wiznetmaker-contest/W5300-Camera-ToF-3D/docs/with-transformer.jpg

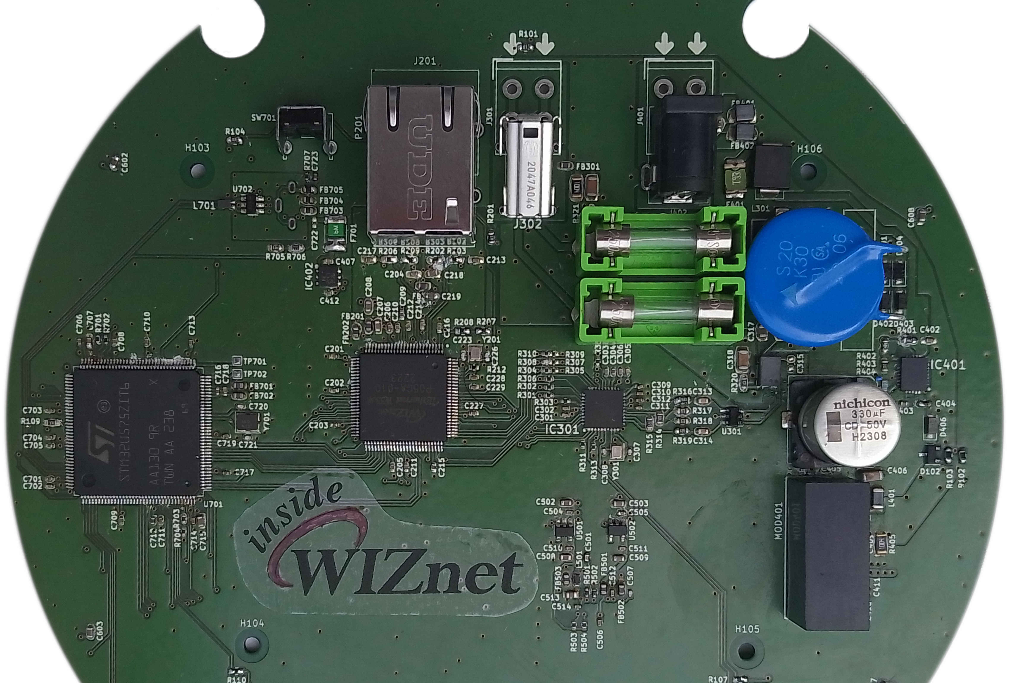
docs/with-transformer.jpg
