wiznetmaker-contest/W5300-Camera-ToF-3D/docs/PCB-Top.jpg

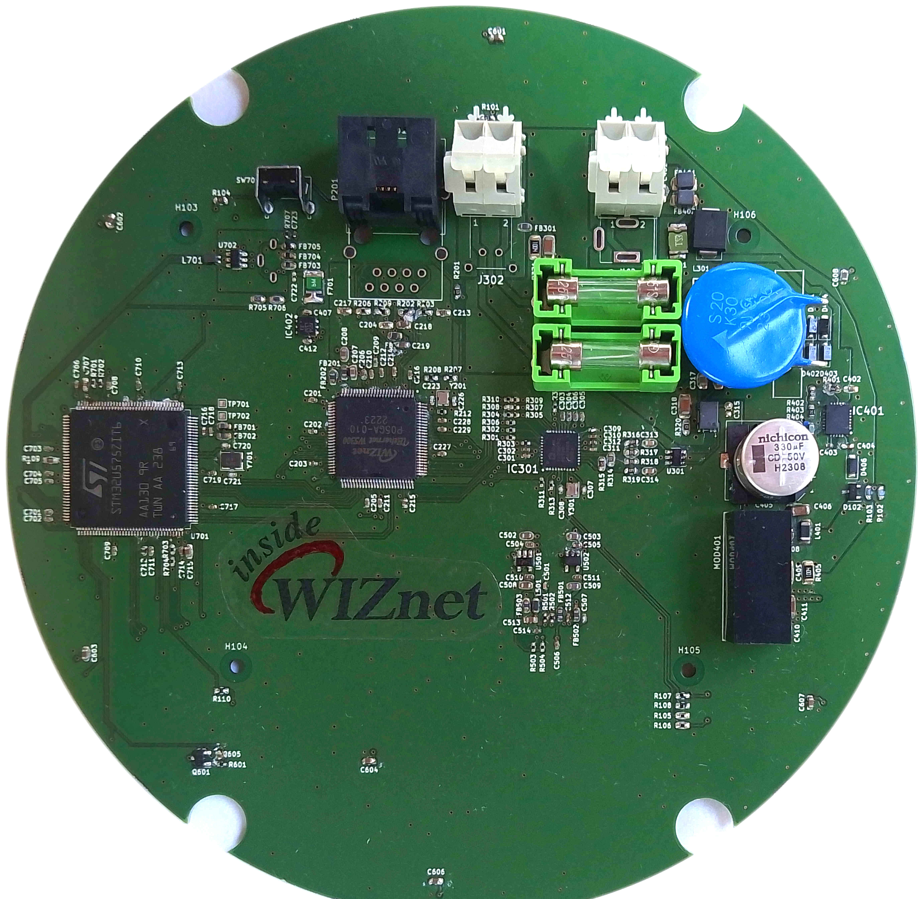
docs/PCB-Top.jpg
