wiznetmaker-contest/W5300-Camera-ToF-3D/docs/Camera part W5300 3D IP Camera.pdf

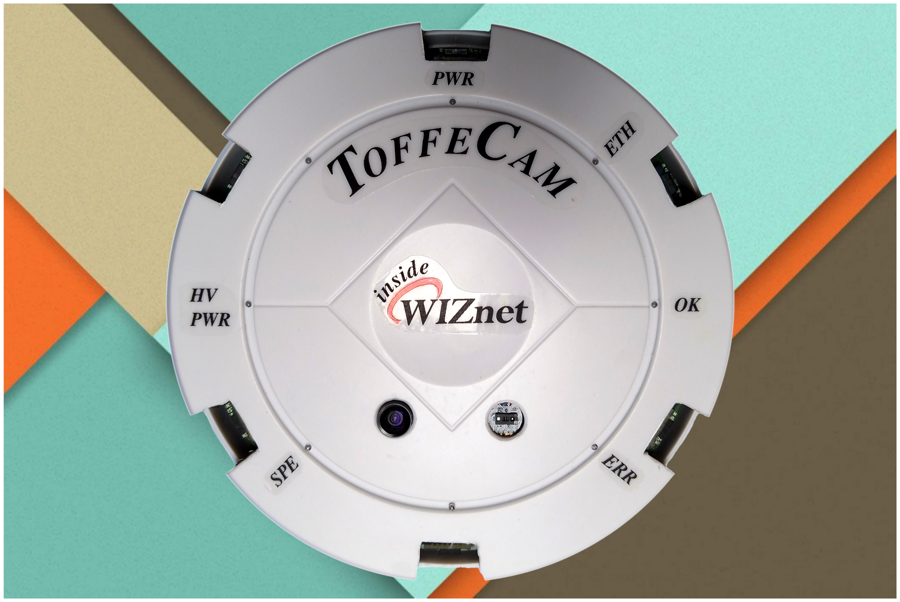
[picture p3: figure]

# W5300 IP 3D Camera over Single Pair Ethernet “ToffeCam” Camera Part

### 19th August 2023

## Jaroslaw Juda

### jarojuda@gmail.com https://github.com/jarojuda

1

OV2640 Camera Module | 1
Fig. 1. OV2640 Module schematics | 1

## OV2640 Camera Module

The device is equipped with the OV264 camera module with a wide-angle lens.
The module needs two additional supply voltages 1.2V and 2.8V. The clock frequency of 24MHz is generated by the PWM output of the microcontroller.

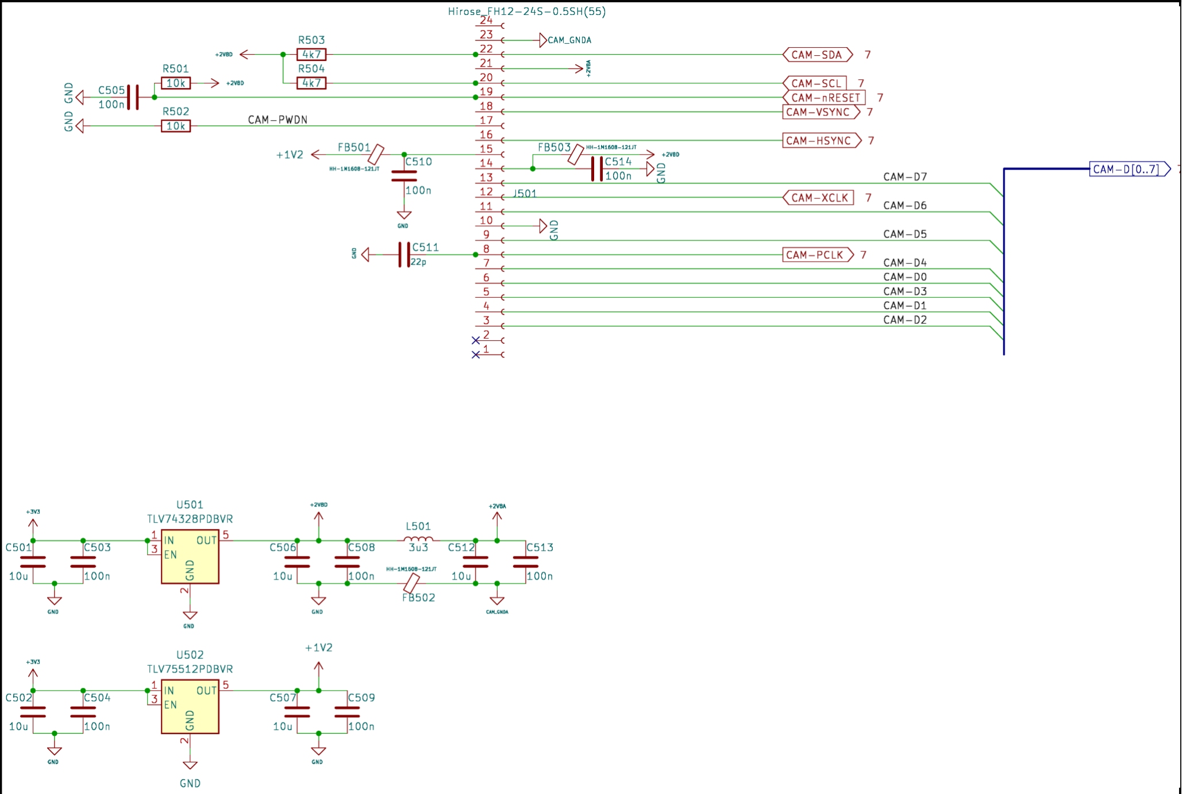
[picture p4: figure]

## Fig. 1. OV2640 Module schematics
