wiznetmaker-contest/W5300-Camera-ToF-3D/docs/MCU and Power Supply part W5300 3D IP Camera.pdf

# W5300 IP 3D Camera over Single Pair Ethernet “ToffeCam” MCU and Power Supply Part

### 19th August 2023

## Jaroslaw Juda

### jarojuda@gmail.com https://github.com/jarojuda

## MCU

The STM32U575ZI (https://www.st.com/en/microcontrollers-microprocessors/stm32u575zi.html) was chosen for its low power consumption and high computing power. Supply voltage 3.3V.
16MHz external quartz clock.

Interfaces used:
- I2C to control ToF sensors and camera
- SPI to emulate MDIO for ADIN1100
- USB for diagnostics
- DCMI for the OV2640 camera module
- FMC for the W5300 Internet coprocessor
- PWM for generating clock the OV2640 camera module

## Power Supply

The device can be powered from three sources:
- Locally from a 24V power supply,
- Remotely via Power over Data Line
- Via USB with 5V voltage
PoDL and 24V power goes through the TPS26400 (https://www.ti.com/product/TPS2640) protection chip which has the following thresholds set: 18V undervoltage, 30V overvoltage and 0.2A current limit. An isolated DC/DC converter provides an output voltage of 3.3 V.
Power from USB goes through the LDL112PV3R (https://www.st.com/en/power-management/ldl112.html) LDO with reverse current protection.

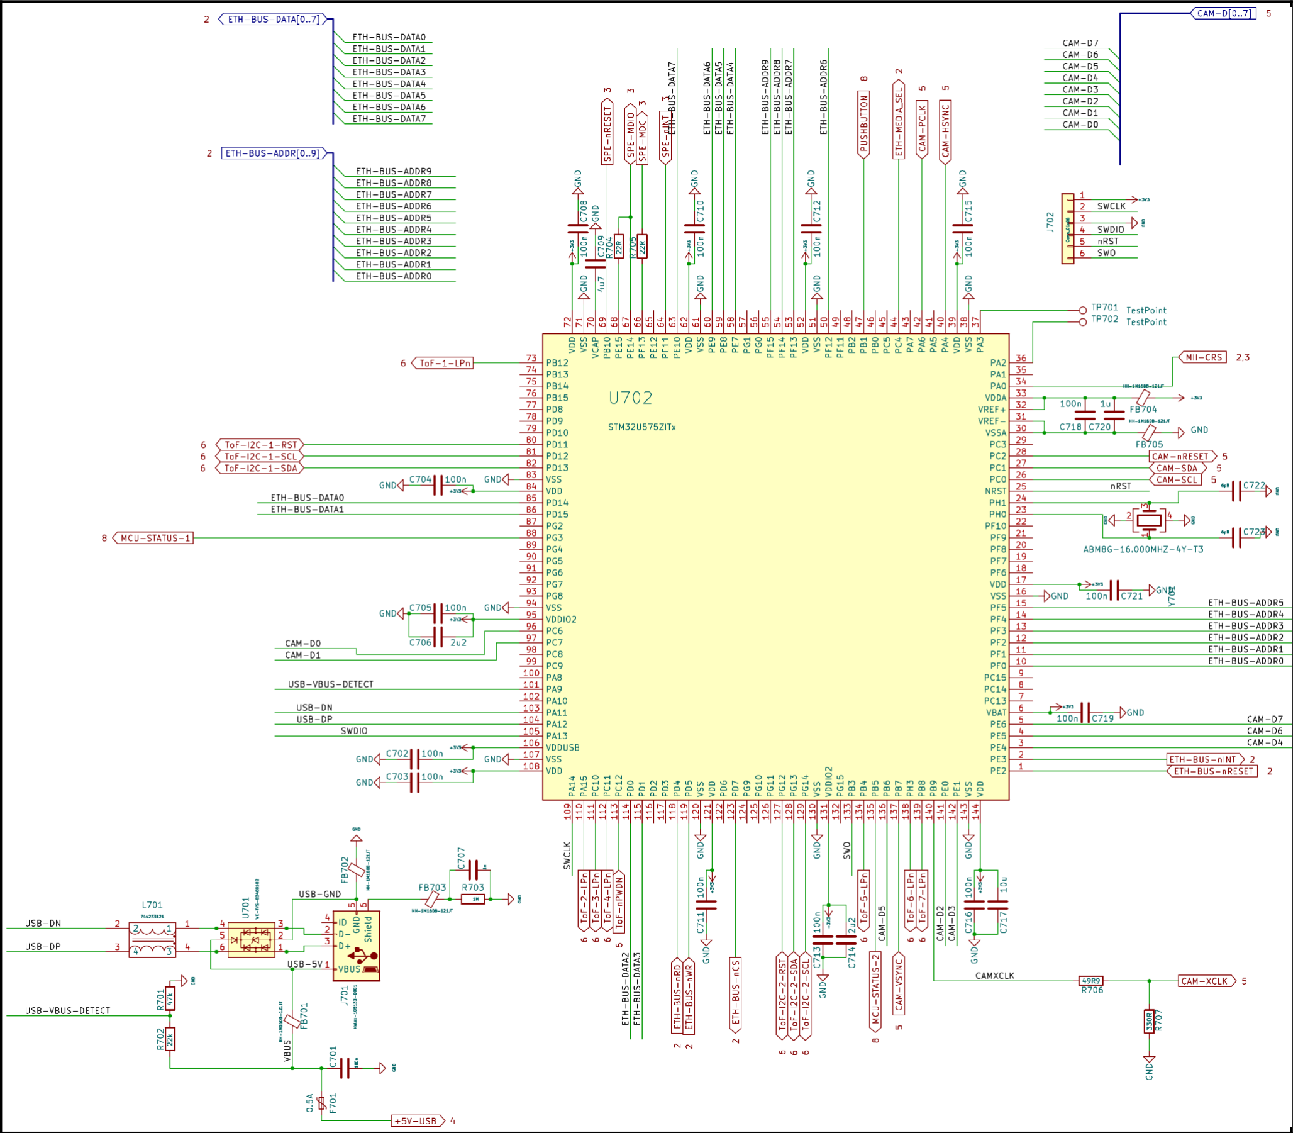
[picture p6: figure]

## Fig. 1. MCU schematics

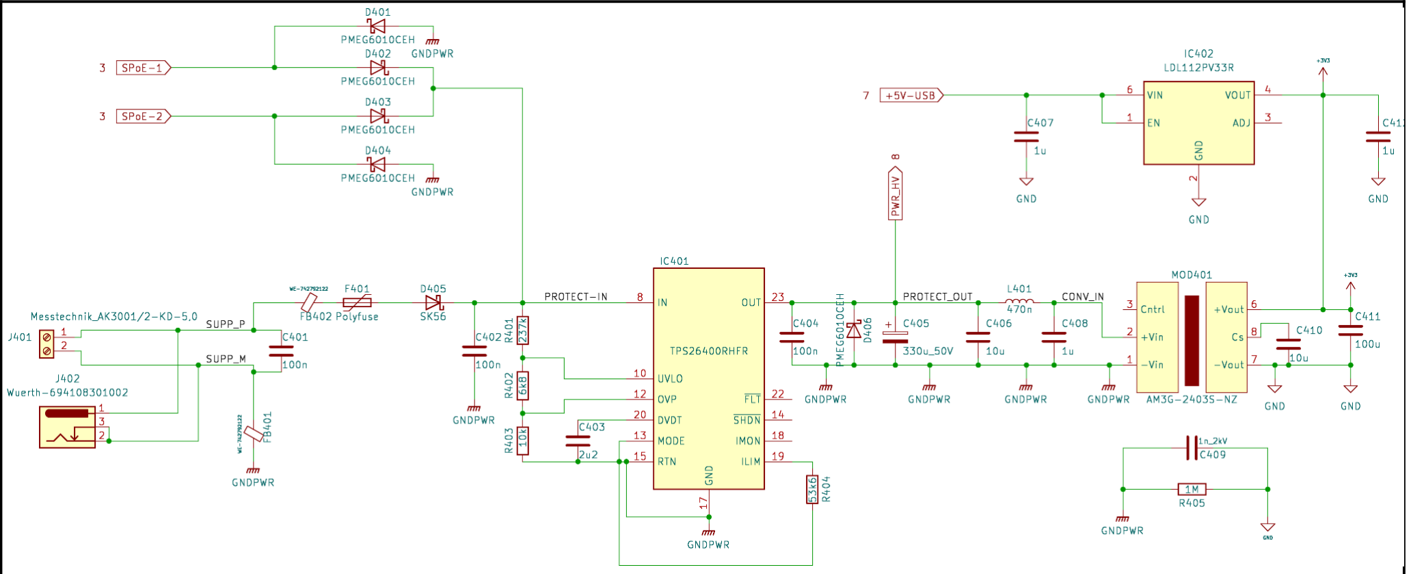
[picture p7: figure]

## Fig. 2. Power supply schematics
