wiznetmaker-contest/W5300-Camera-ToF-3D/docs/ToF Sensors Matrix part W5300 3D IP Camera.pdf

# W5300 IP 3D Camera over Single Pair Ethernet ToF Sensors Matrix Part

### 19th August 2023

## Jaroslaw Juda

### jarojuda@gmail.com https://github.com/jarojuda

## VL53L7CX Sensors Matrix Geometry

VL53L7Cx (https://www.st.com/en/imaging-and-photonics-solutions/vl53l7cx.html) is a time-of-Flight 8x8 multizone ranging sensor. Its field of view is 60 x 60 degrees. Seven sensors are needed to cover the entire hemisphere. Six are arranged in a circle every 60 degrees, the seventh looks vertically upwards.

TBD

## Fig. 1. Placement of Sensors

The sensor is mounted on a separate board, its axis is directed at an angle of 30 degrees to the horizontal (Fig.2).

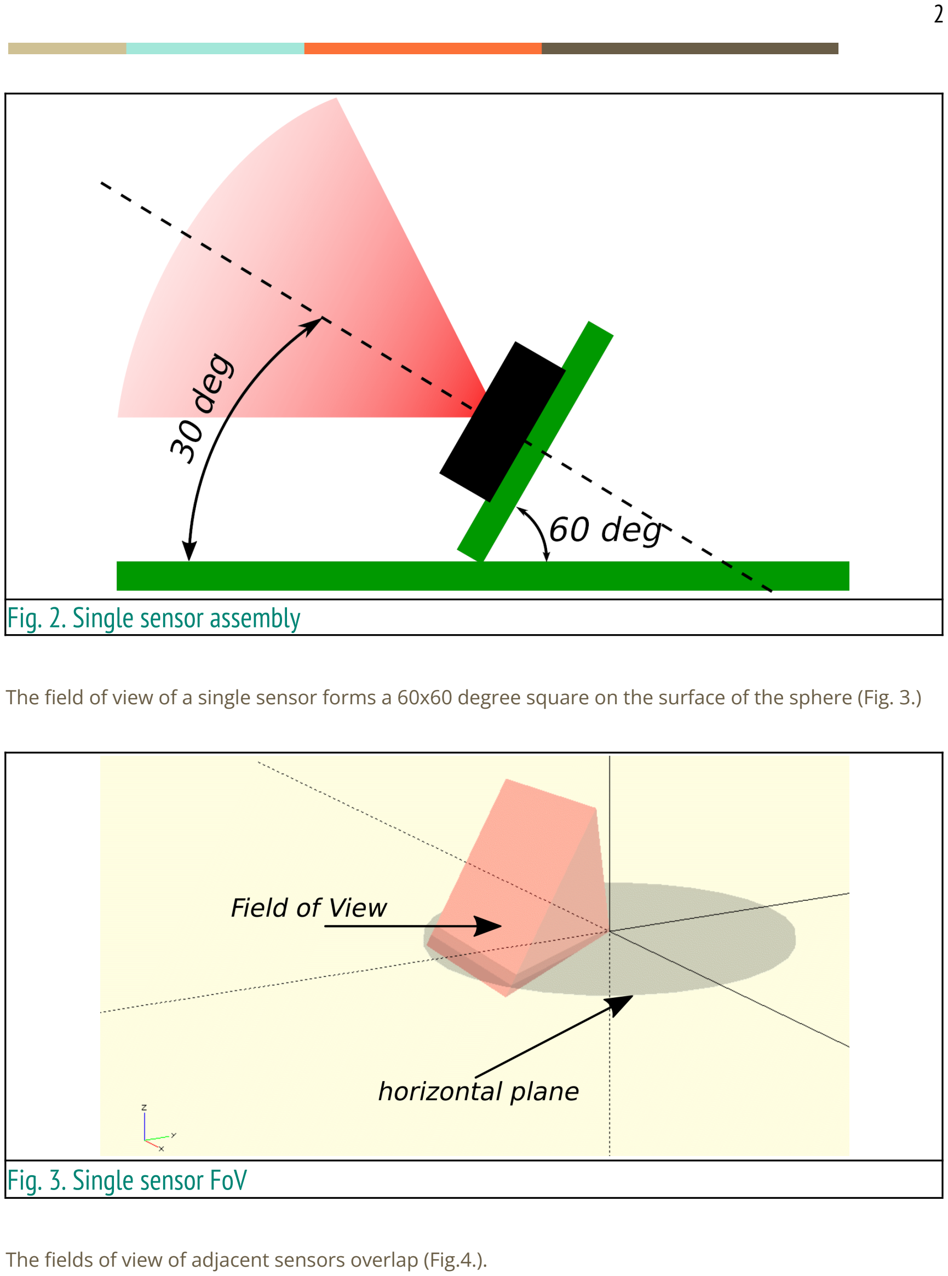
[picture p11: page 3]

## Fig. 2. Single sensor assembly

The field of view of a single sensor forms a 60x60 degree square on the surface of the sphere (Fig. 3.)

## Fig. 3. Single sensor FoV

The fields of view of adjacent sensors overlap (Fig.4.).

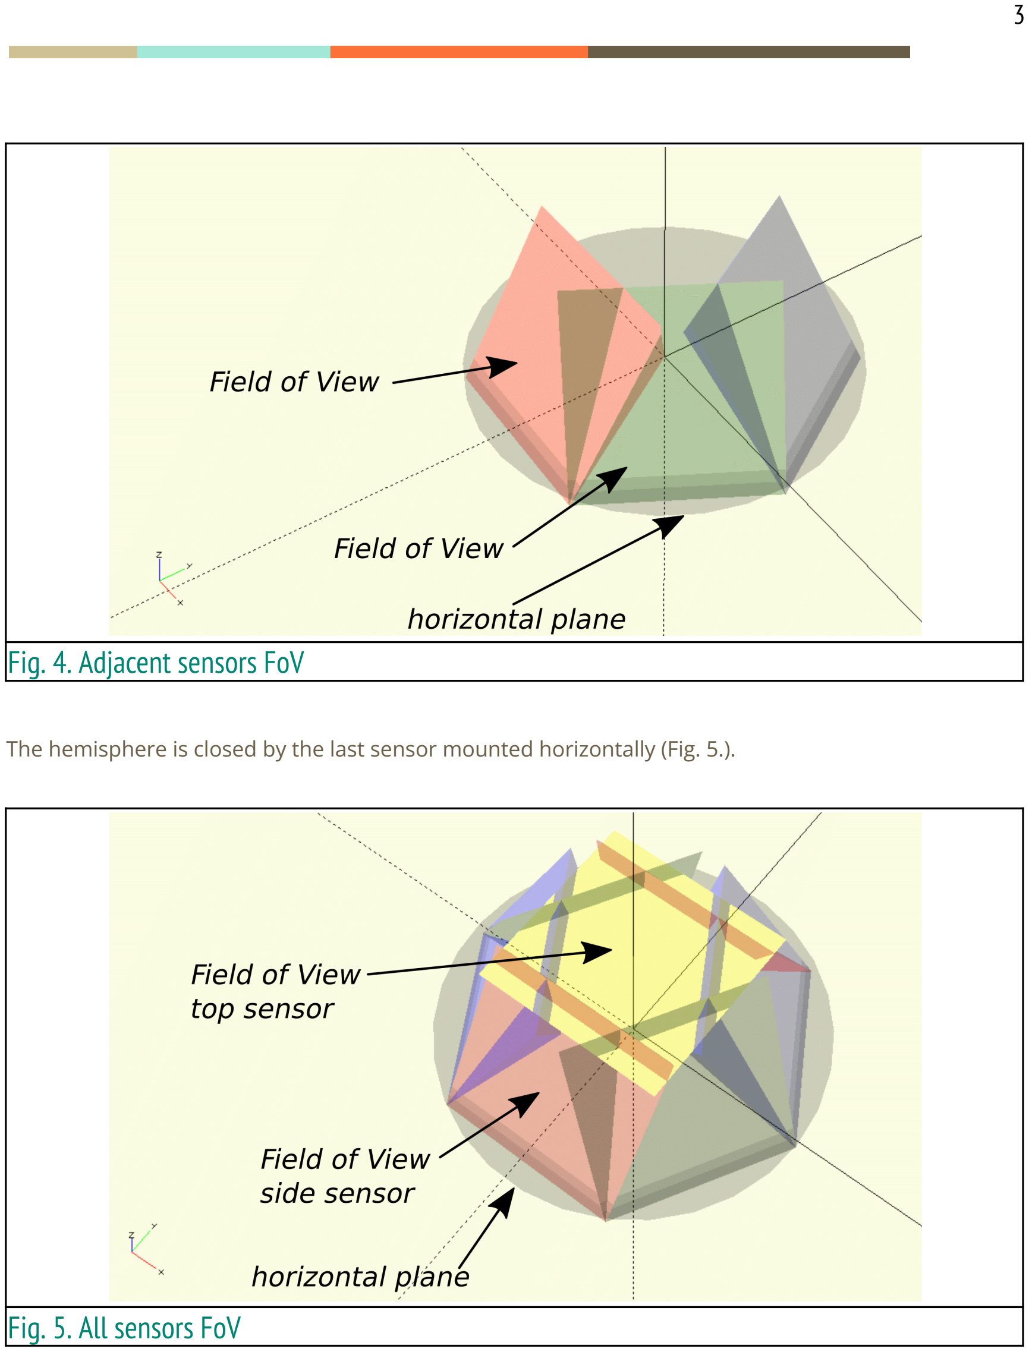
[picture p12: page 4]

## Fig. 4. Adjacent sensors FoV

The hemisphere is closed by the last sensor mounted horizontally (Fig. 5.).

## Fig. 5. All sensors FoV

## VL53L7CX Sensors Matrix Schematics

The sensors share two I2C buses. Power-off reset is common to all sensors. Each sensor has its own LPn signal mainly needed to change the address on the I2C bus (Fig.6.).

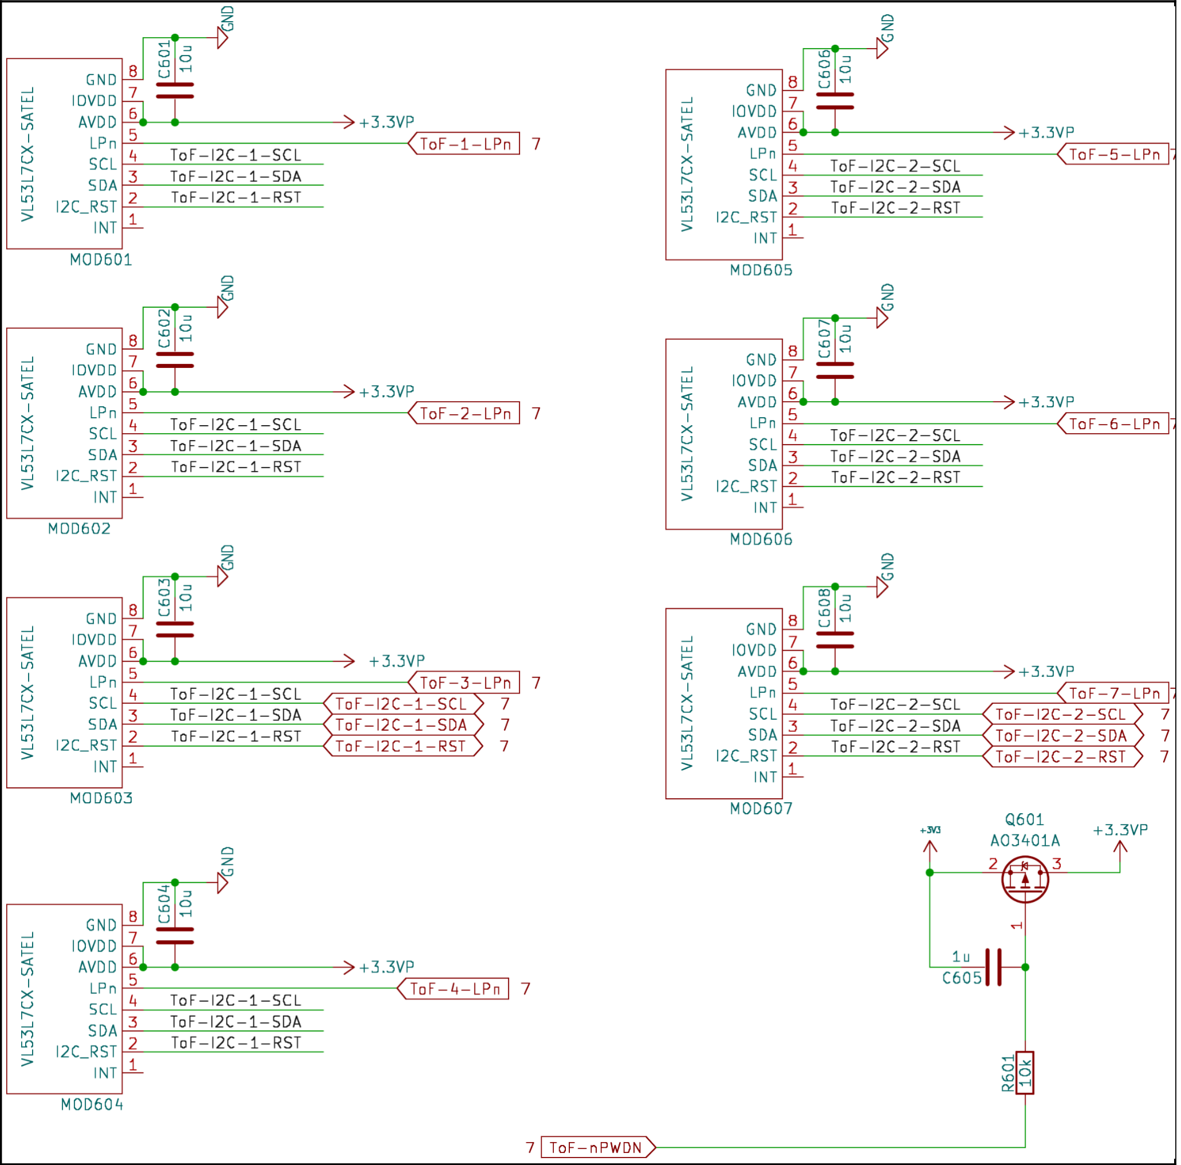
[picture p13: figure]

## Fig. 6. ToF sensors matrix schematics
