wiznetmaker-contest/W5300-Camera-ToF-3D/docs/Block-Diagram.png

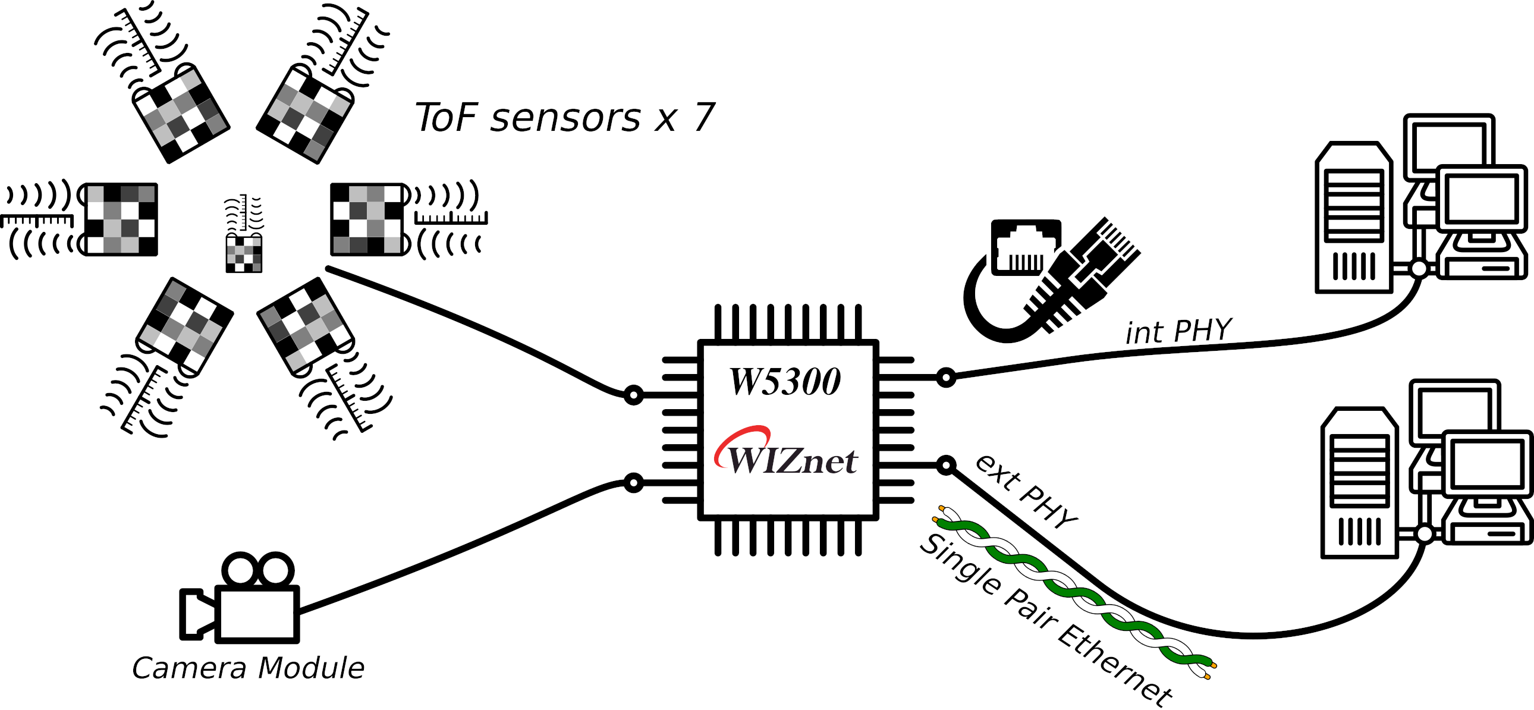
docs/Block-Diagram.png
