wiznetmaker-contest/W5300-Camera-ToF-3D/docs/Front-View.png

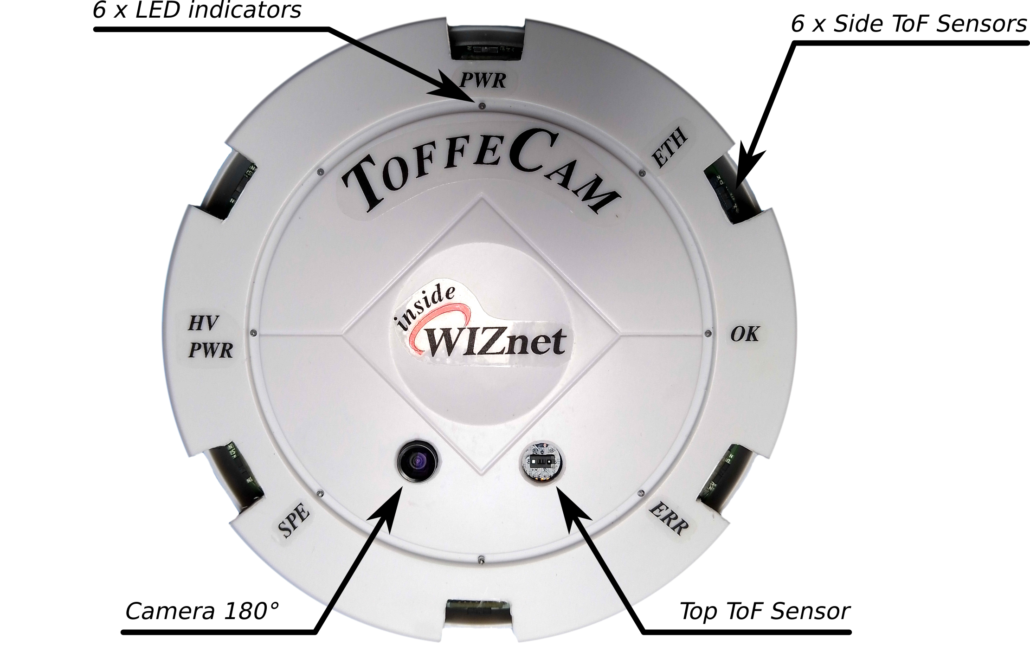
docs/Front-View.png
