wiznetmaker-contest/W5300-Camera-ToF-3D/docs/PCB-Bottom.jpg

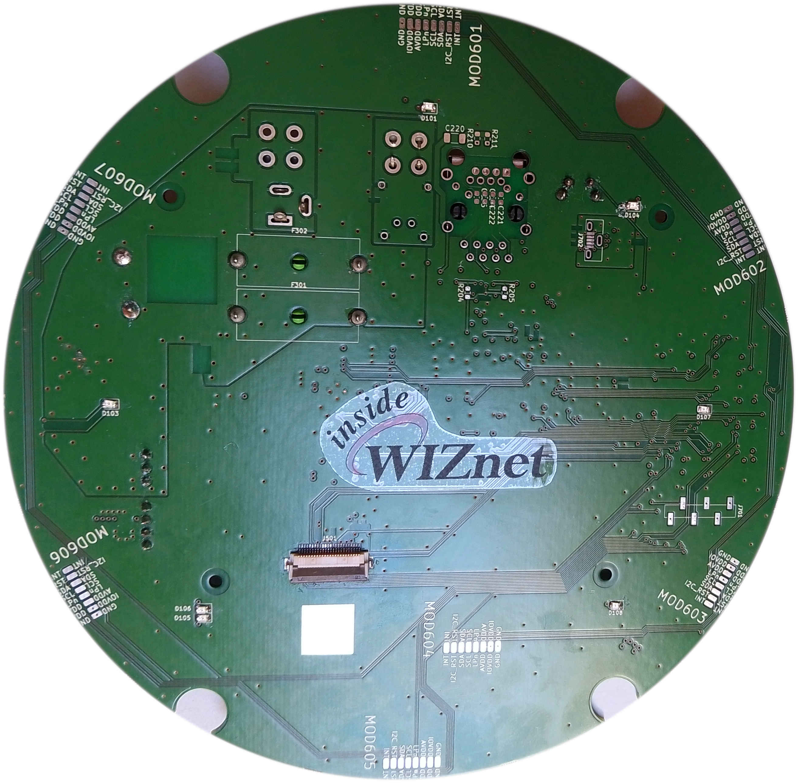
docs/PCB-Bottom.jpg
