wiznetmaker-contest/W5300-Camera-ToF-3D/docs/sch-1.png

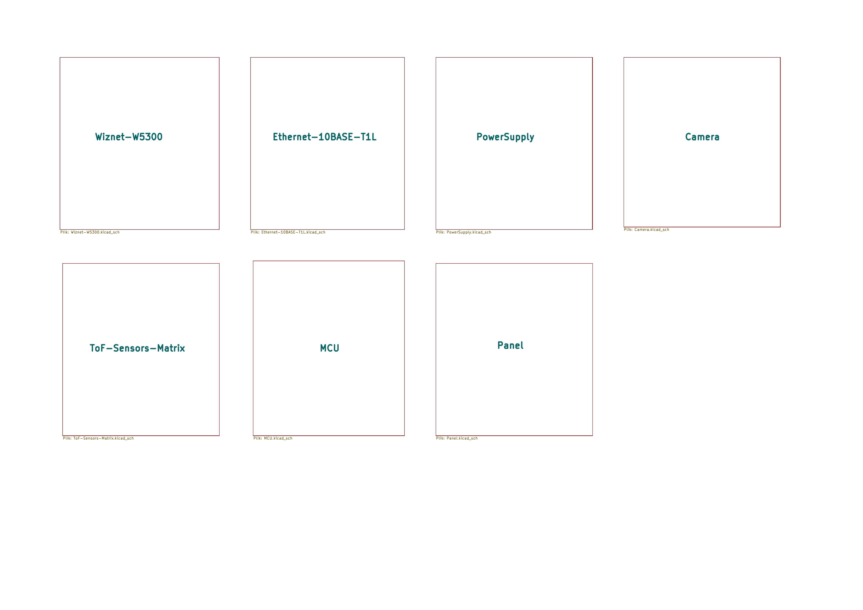
docs/sch-1.png
