wiznetmaker-contest/W5300-Camera-ToF-3D/docs/sch-2.png

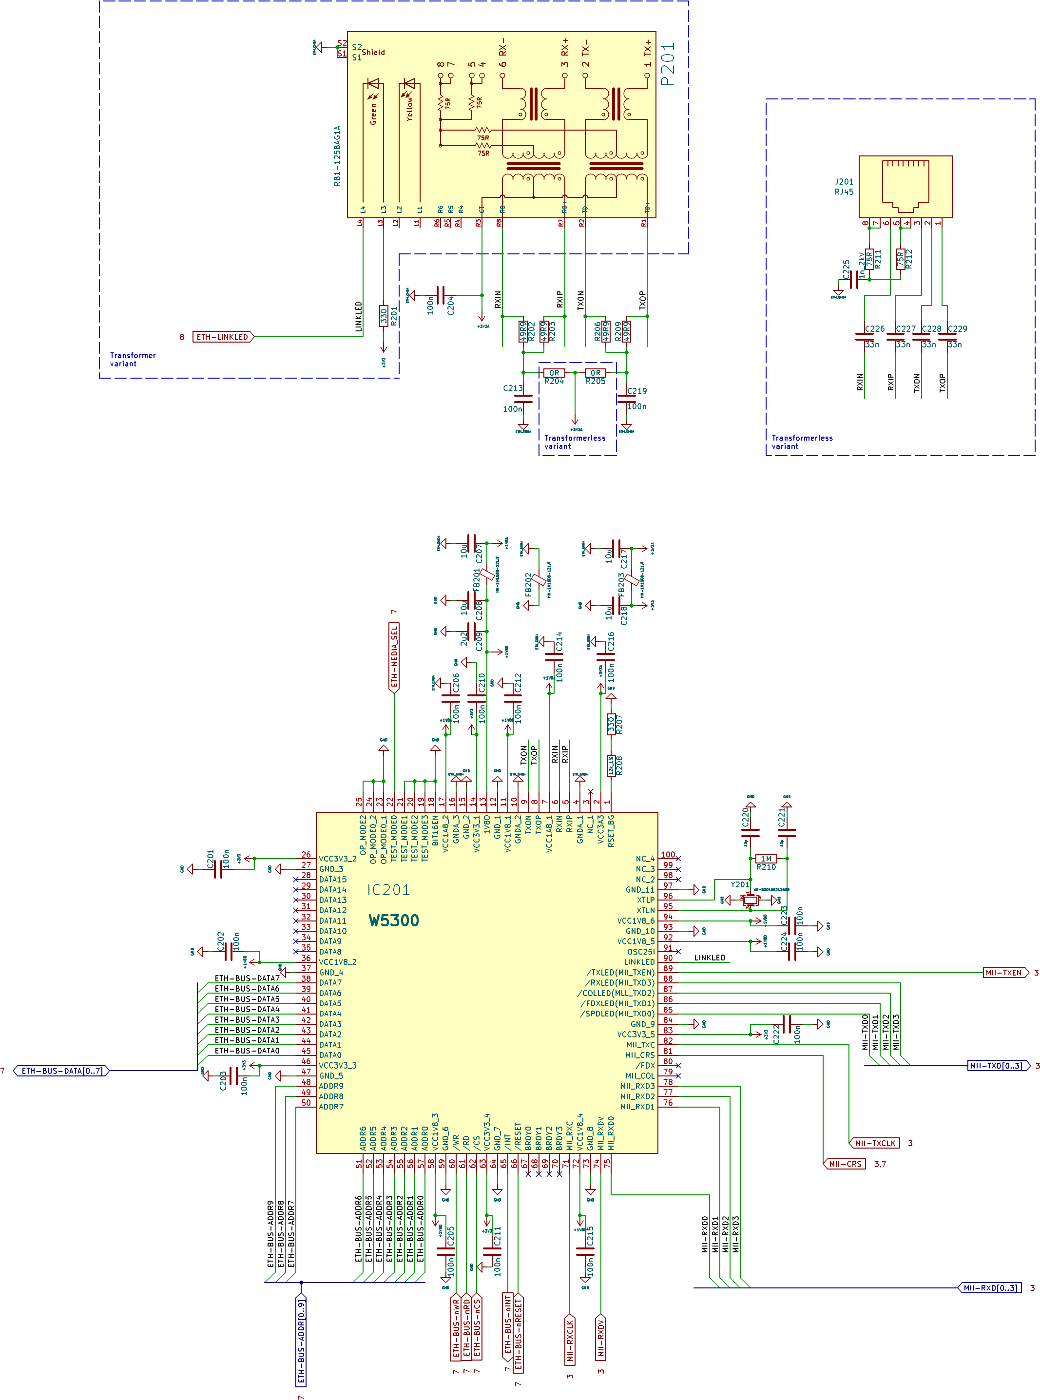
docs/sch-2.png
