wiznetmaker-contest/W5300-Camera-ToF-3D/docs/sch-3.png

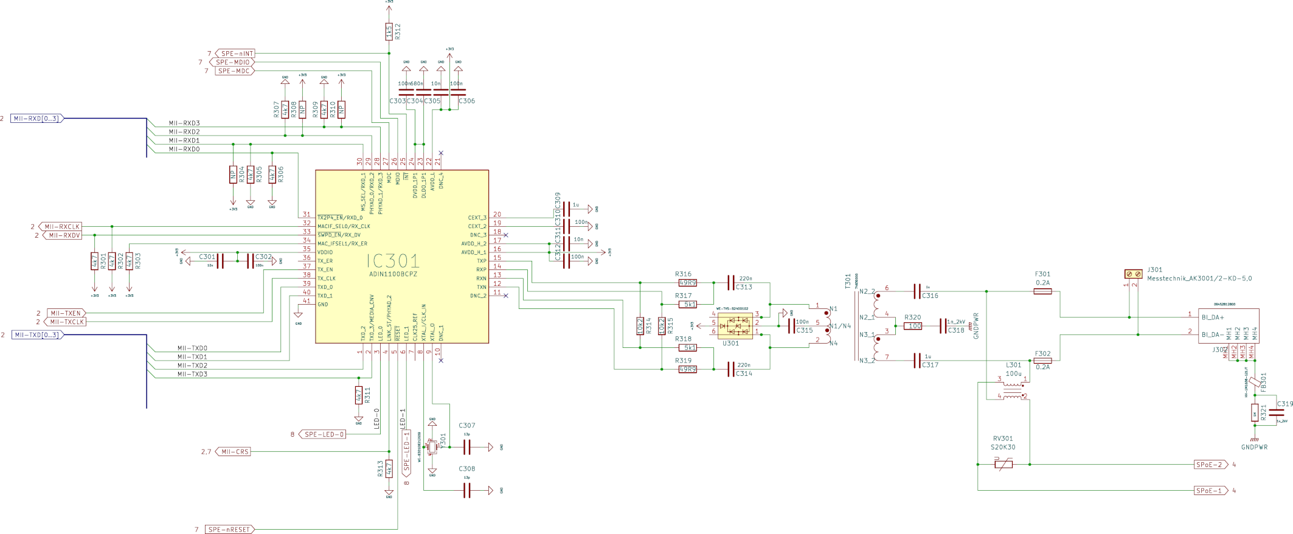
docs/sch-3.png
