wiznetmaker-contest/W5300-Camera-ToF-3D/docs/sch-4.png

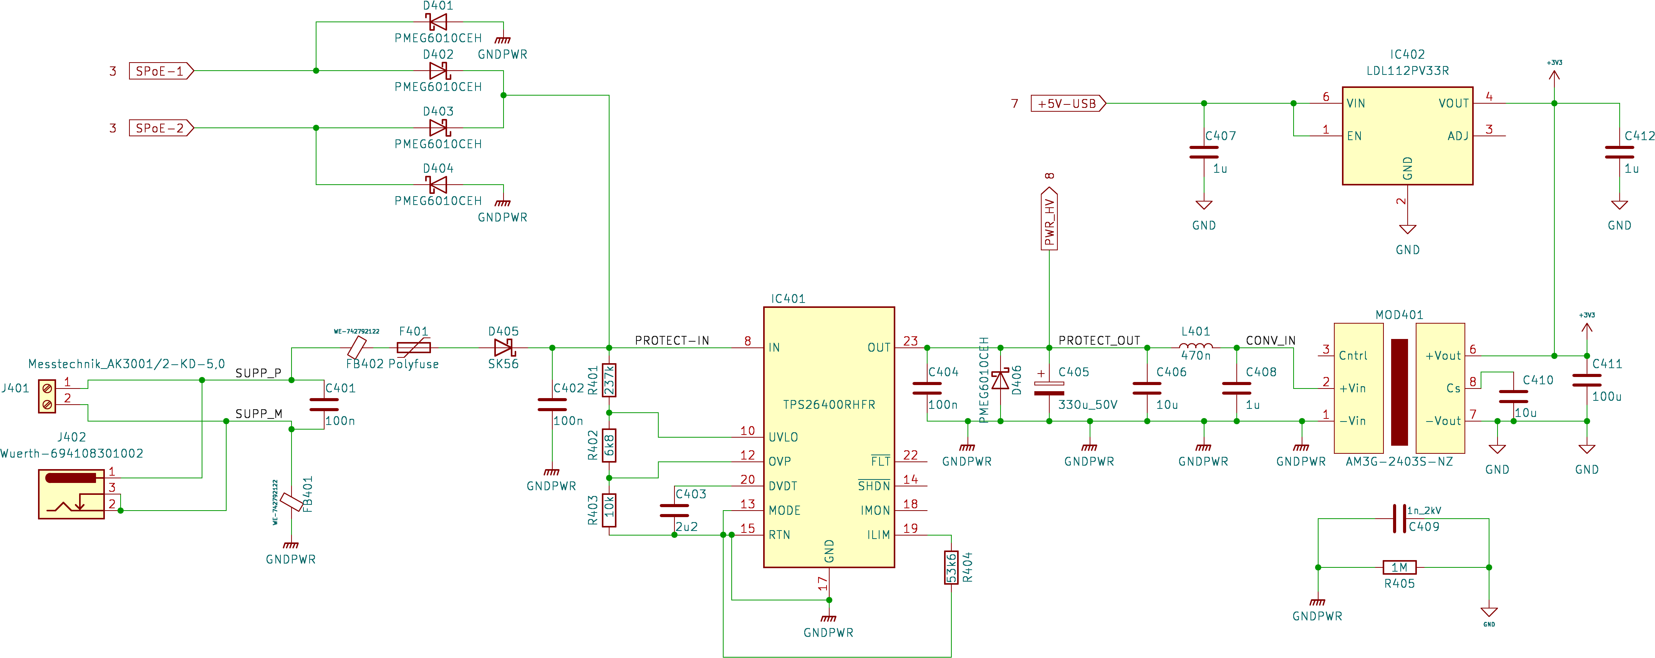
docs/sch-4.png
