wiznetmaker-contest/W5300-Camera-ToF-3D/docs/sch-5.png

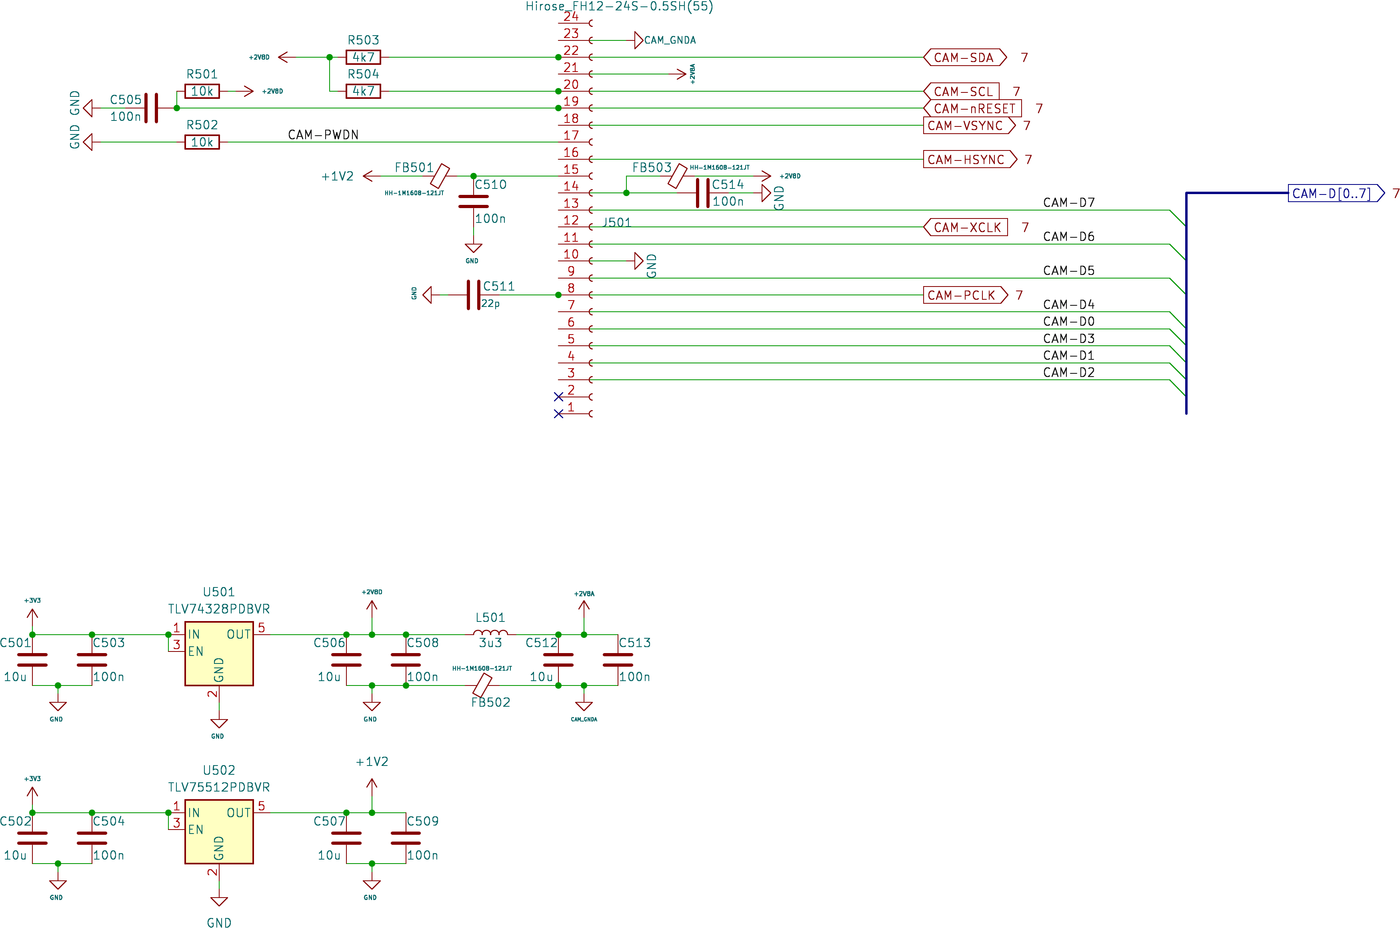
docs/sch-5.png
