wiznetmaker-contest/W5300-Camera-ToF-3D/docs/sch-7.png

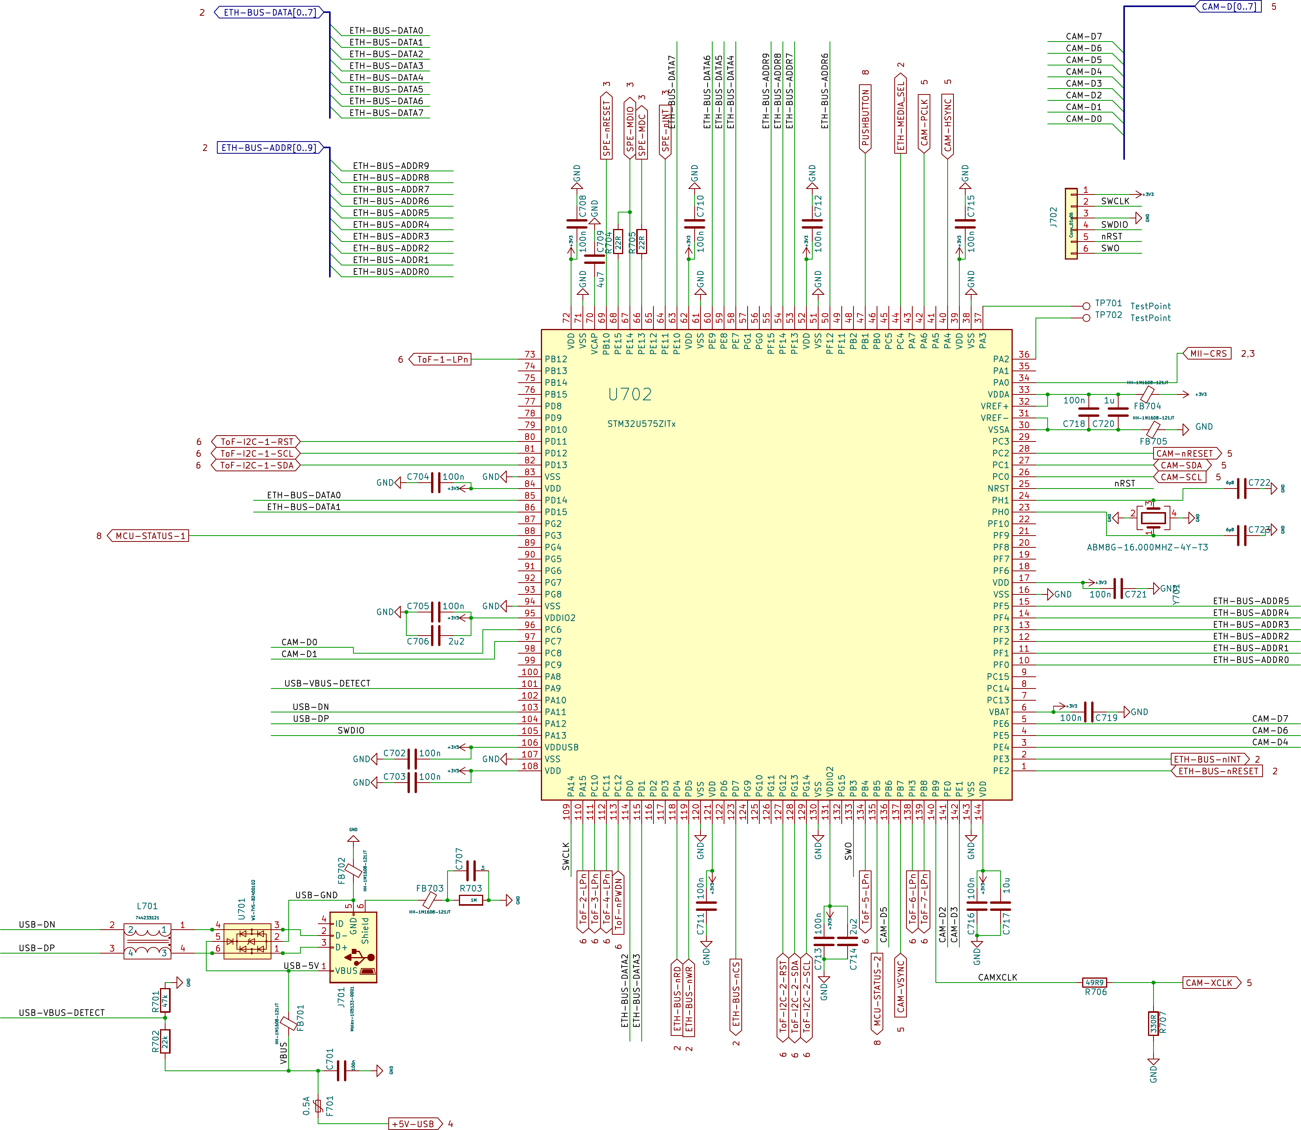
docs/sch-7.png
