wiznetmaker-contest/W5300-Camera-ToF-3D/docs/sch-8.png

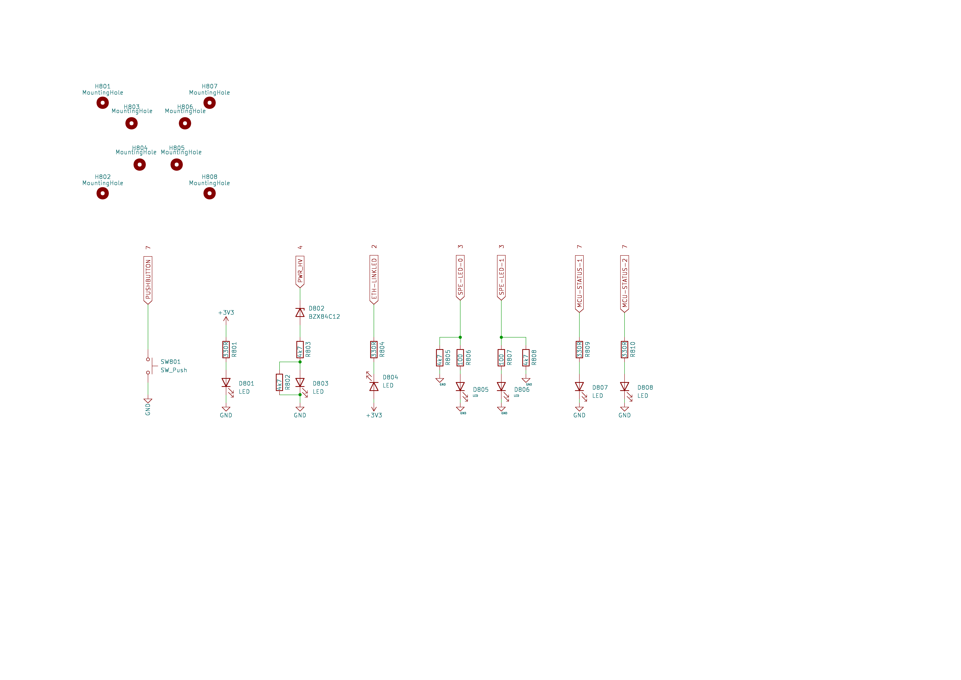
docs/sch-8.png
