wiznetmaker-contest/W5300-Camera-ToF-3D/docs/Side-View.png

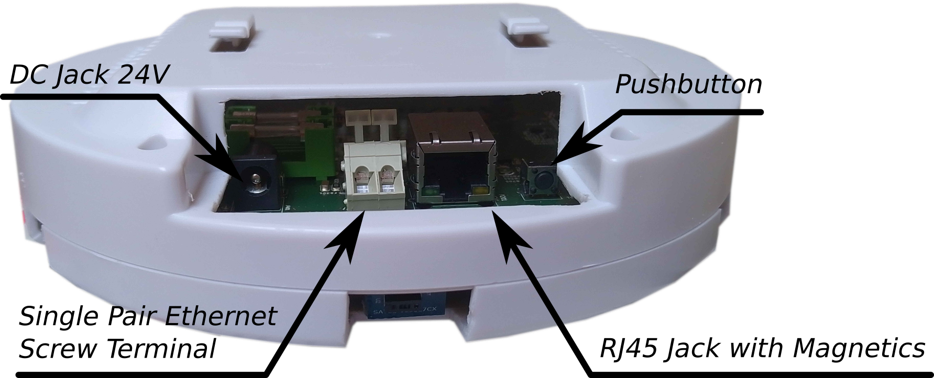
docs/Side-View.png
