wiznetmaker-contest/W5300-Camera-ToF-3D/docs/sockets.jpg

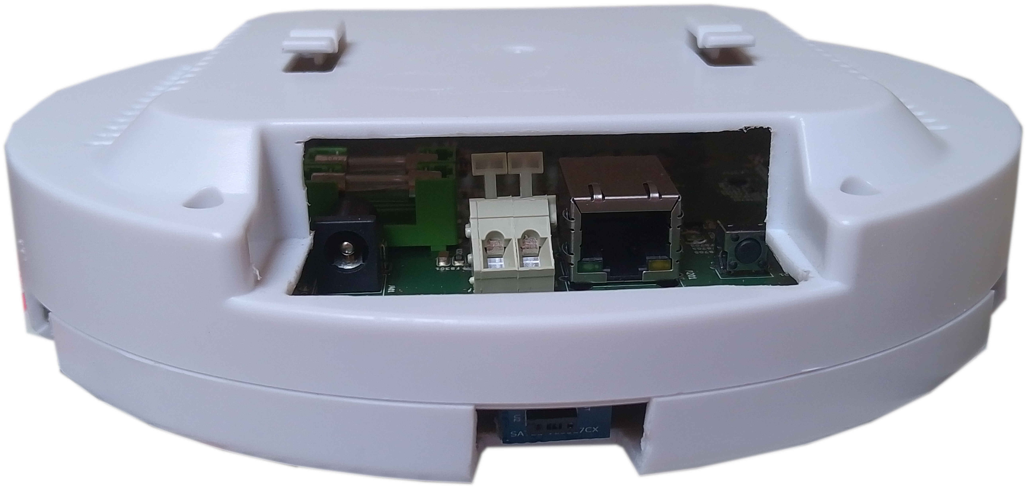
docs/sockets.jpg
