wiznetmaker-contest/W5300-Camera-ToF-3D/docs/ToF-Matrix/1-sensor.png

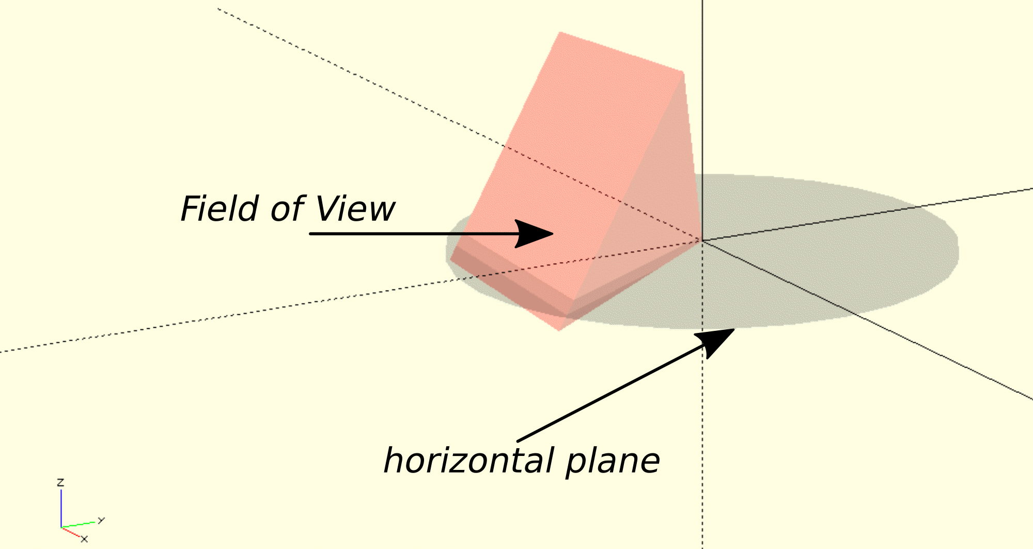
docs/ToF-Matrix/1-sensor.png
