wiznetmaker-contest/W5300-Camera-ToF-3D/docs/ToF-Matrix/3-sensors.png

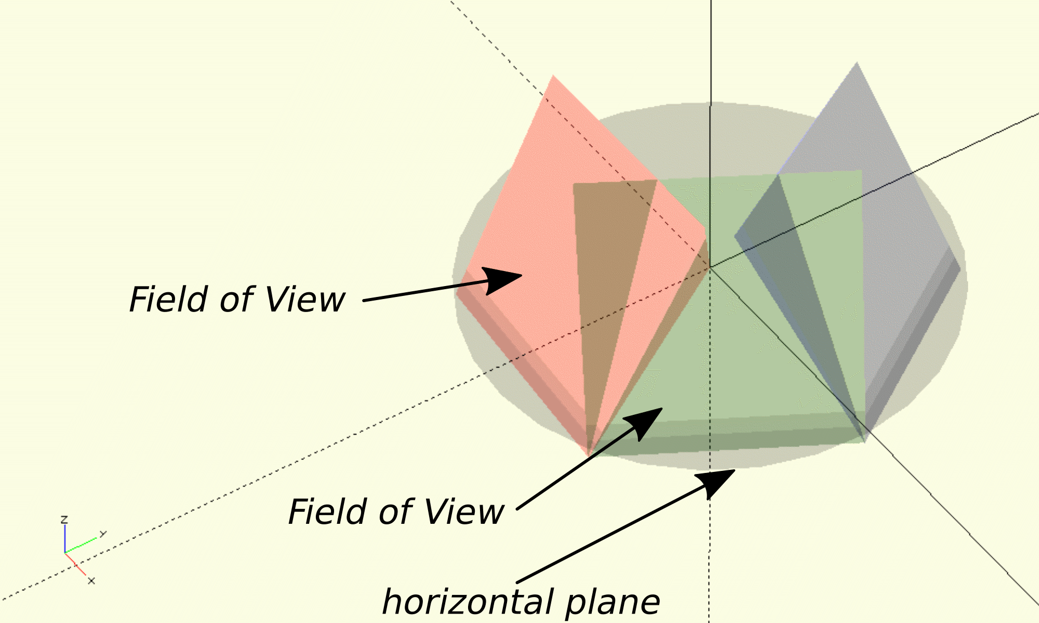
docs/ToF-Matrix/3-sensors.png
