wiznetmaker-contest/W5300-Camera-ToF-3D/docs/ToF-Matrix/all-sensors.png

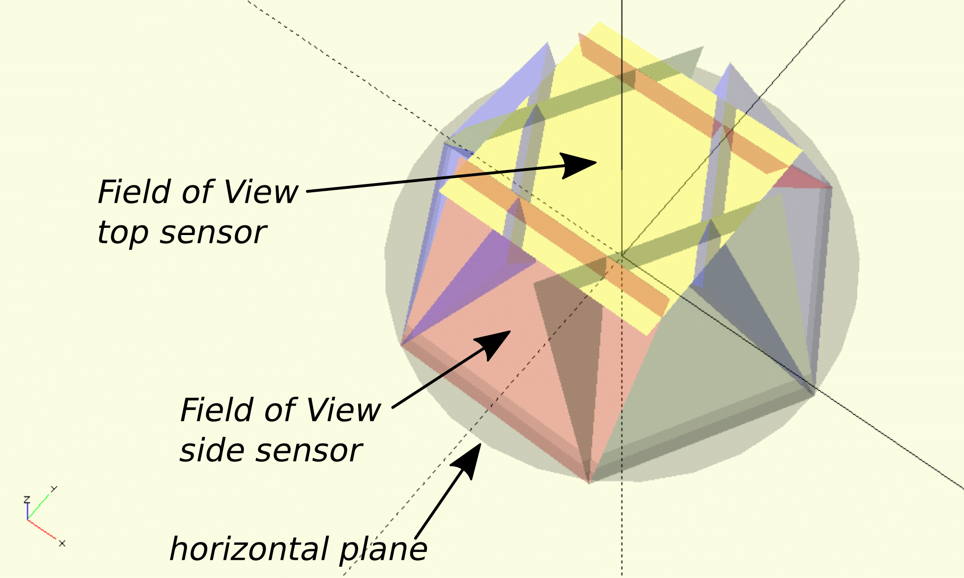
docs/ToF-Matrix/all-sensors.png
