wiznetmaker-contest/W5300-Camera-ToF-3D/docs/ToF-placement.jpg

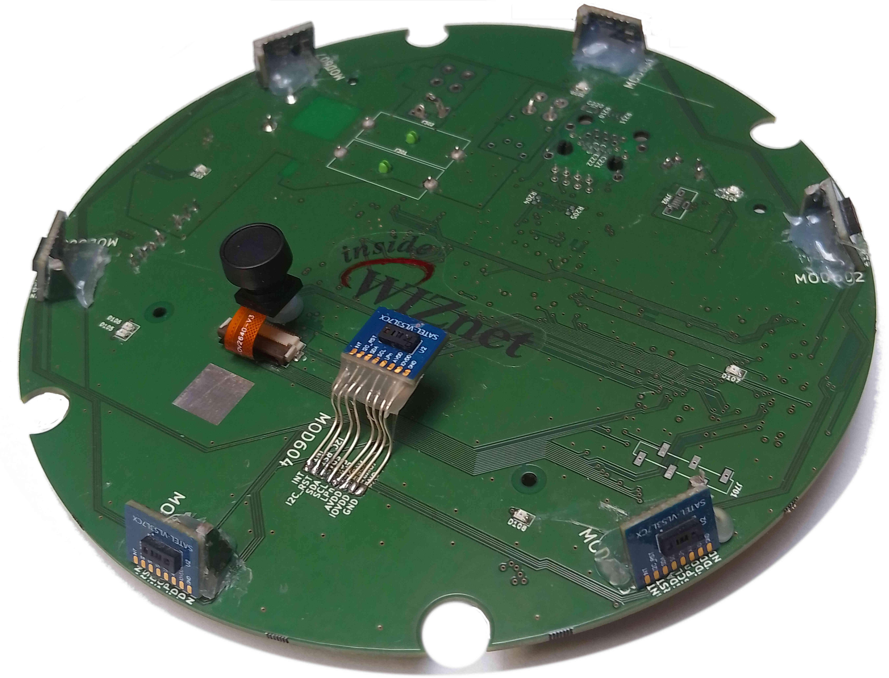
docs/ToF-placement.jpg
