wiznetmaker-contest/W5300-Camera-ToF-3D/docs/transformerless.jpg

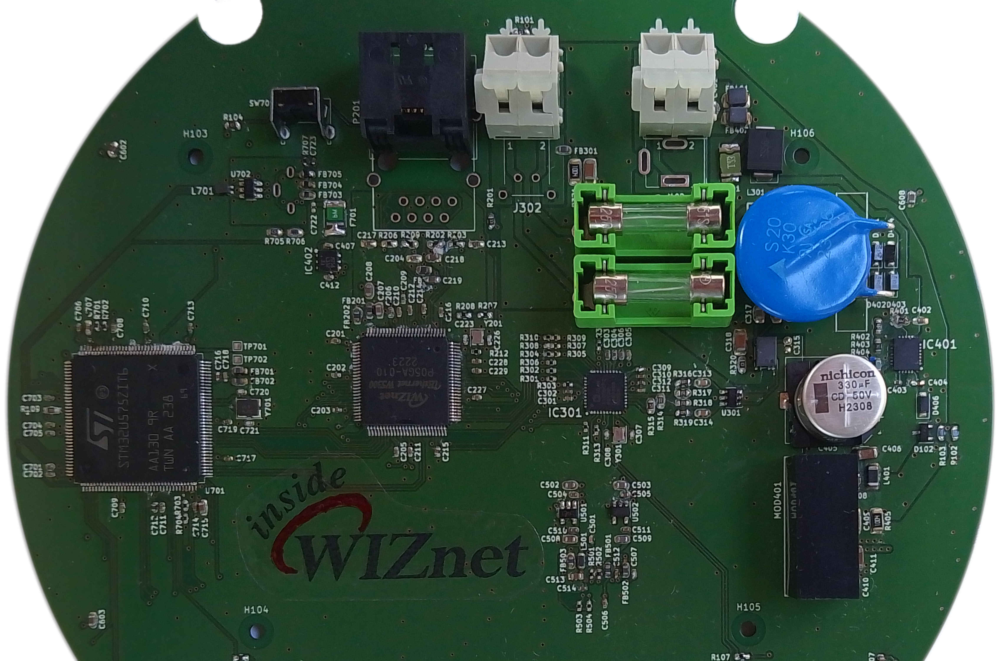
docs/transformerless.jpg
