wiznetmaker-contest/W5300-Camera-ToF-3D/docs/ToF-Matrix/sensor-assembly.png

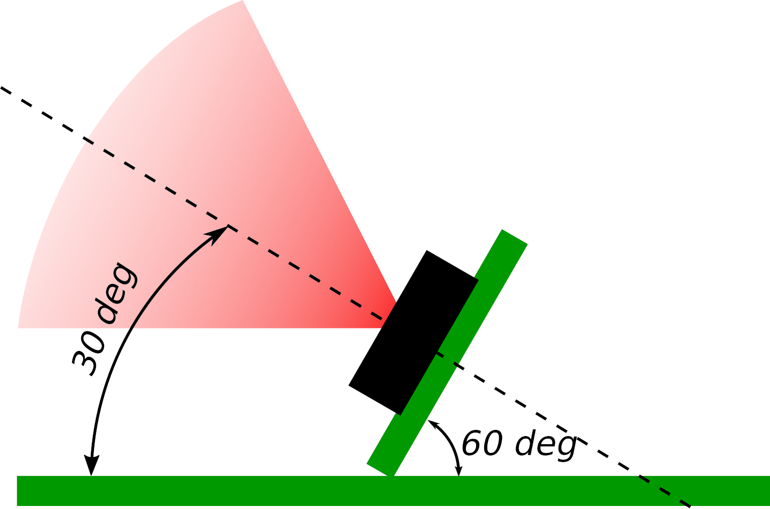
docs/ToF-Matrix/sensor-assembly.png
