wiznetmaker-contest/W5300-Camera-ToF-3D/hardware/ToffeeCam/ToffeeCam.kicad_pcb

## KiCad design hardware/ToffeeCam/ToffeeCam.kicad_pcb (2023-08-12)

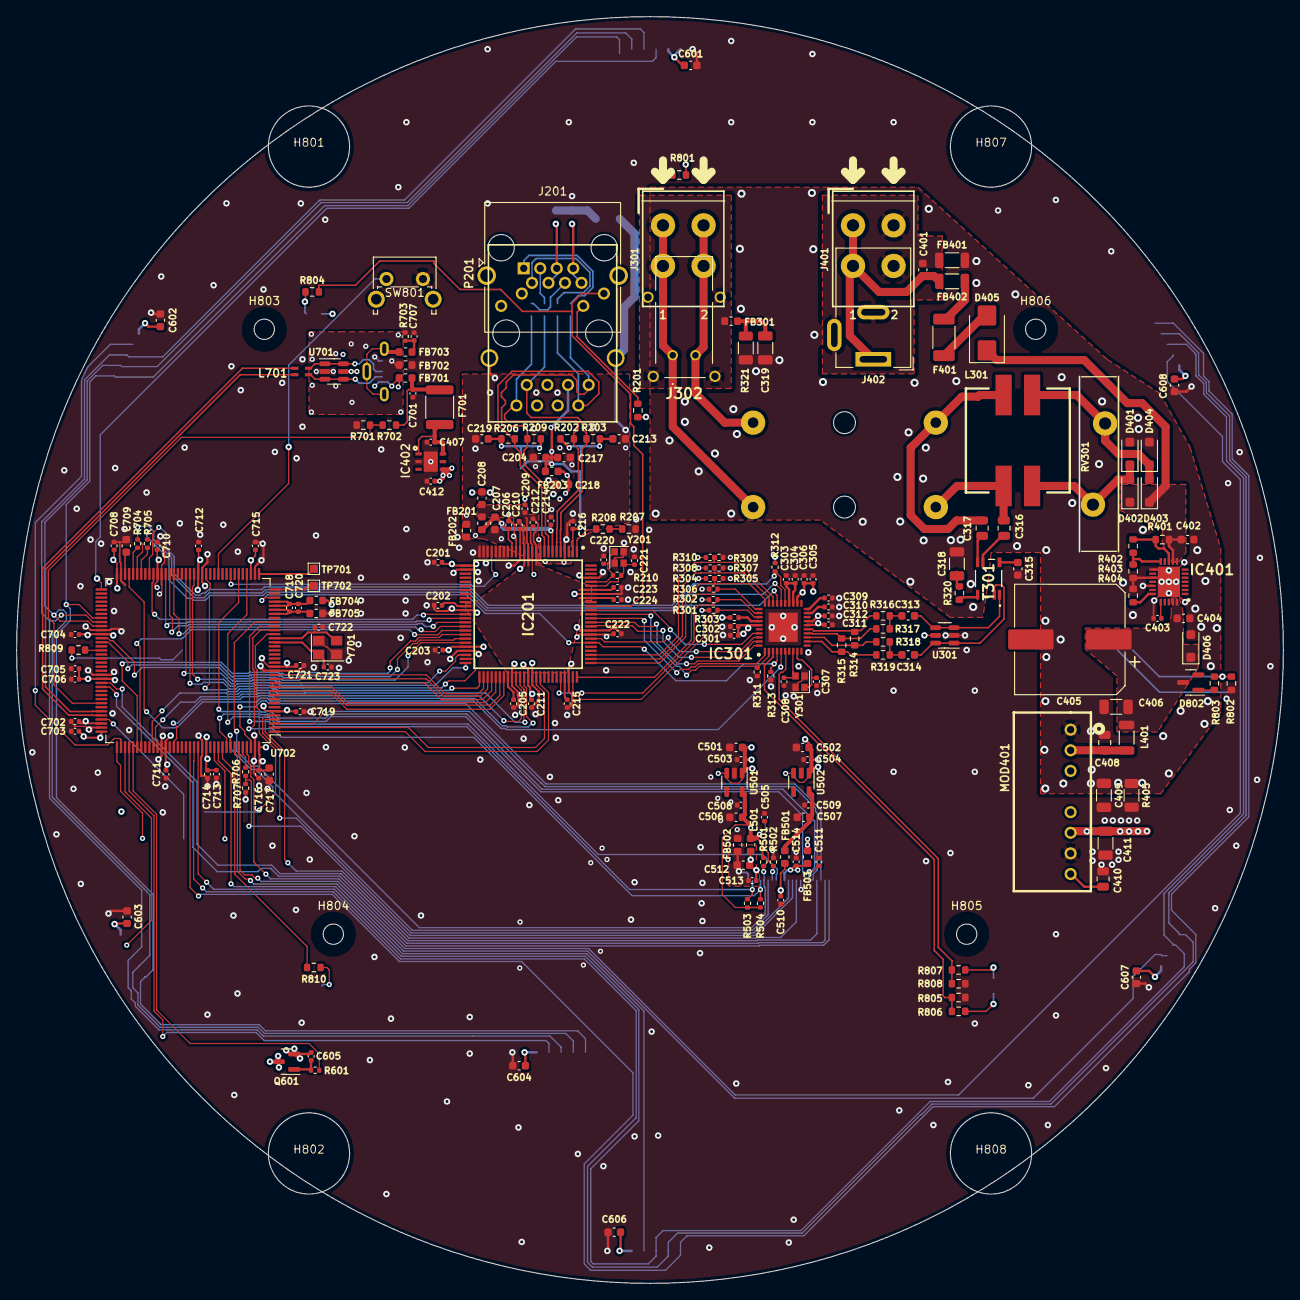
[picture p48: board ToffeeCam.kicad_pcb from above]

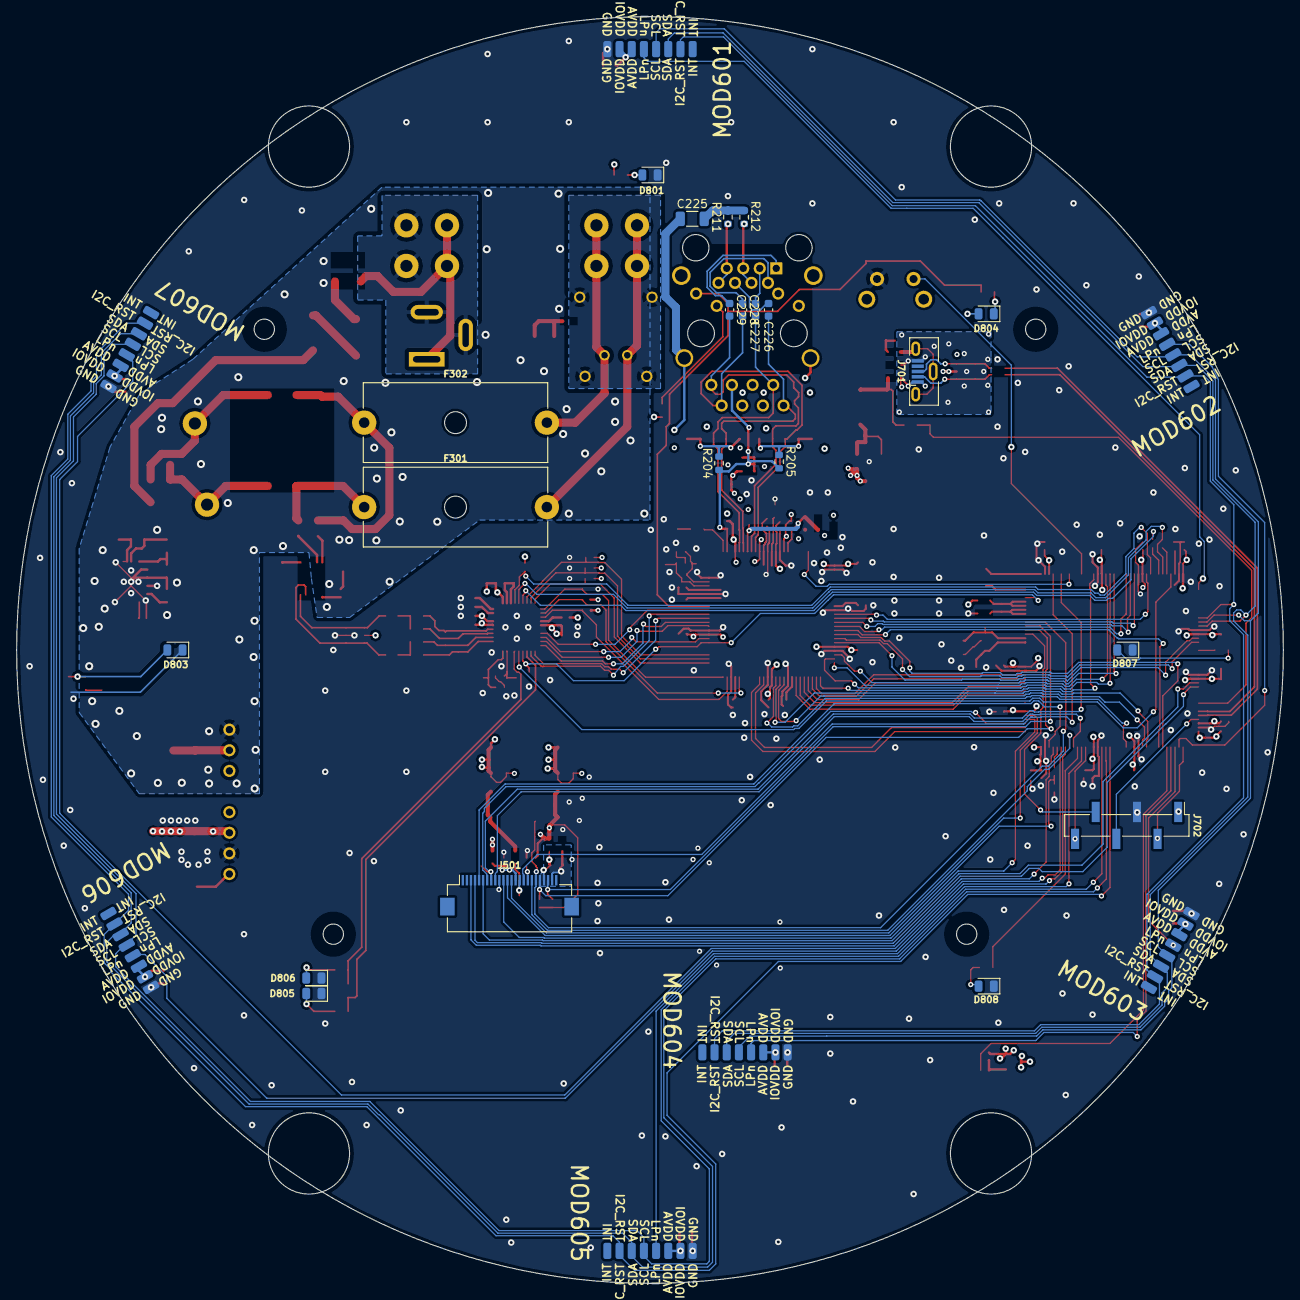
[picture p49: board ToffeeCam.kicad_pcb from below]

Board: 4 copper layers, 156.0 x 156.0 mm, 244 parts (28 on the bottom side), 182 nets.

Parts:
C201, C202, C203, C205, C206, C210, C211, C212, C214, C215, C216, C222, C223, C224, C302, C303, C306, C310, C312, C503, C504, C505, C508, C509, C510, C513, C514, C701, C702, C703, C704, C705, C708, C710, C711, C712, C713, C715, C716, C718, C719, C721: 100n; C_0402_1005Metric
C204, C213, C219, C315, C401, C402, C404: 100n; C_0603_1608Metric
C207, C208, C217, C218, C501, C502, C506, C507, C512, C601, C602, C603, C604, C606, C607, C608, C717: 10u; C_0603_1608Metric
C209, C403, C706, C714: 2u2; C_0402_1005Metric
C220, C221: 13p; C_0402_1005Metric
C225, C318, C319, C409: 1n_2kV; C_1206_3216Metric
C226, C227, C228, C229: 33n; C_0603_1608Metric
C301, C305, C311: 10n; C_0402_1005Metric
C304: 680n; C_0402_1005Metric
C307, C308: 16p; C_0402_1005Metric
C309, C407, C412, C605, C720: 1u; C_0402_1005Metric
C313, C314: 220n; C_0603_1608Metric
C316, C317, C408: 1u; C_0805_2012Metric
C405: 330u_50V; CP_Elec_12,5x13.5
C406: 10u; C_1206_3216Metric
C410: 10u; C_0805_2012Metric
C411: 100u; C_1206_3216Metric
C511: 22p; C_0402_1005Metric
C707: 1n; C_0402_1005Metric
C709: 4u7; C_0603_1608Metric
C722, C723: 6p8; C_0402_1005Metric
D401, D402, D403, D404, D406: PMEG6010CEH; D_SOD-123F
D405: SK56; D_SMB
D801, D803, D804, D805, D806, D807, D808: LED; LED_0805_2012Metric
D802: BZX84Cxx; SOT-23
F301, F302: Fuse; Fuseholder_Cylinder-5x20mm_Schurter_0031_8201_Horizontal_Op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
F401: Polyfuse; Fuse_2010_5025Metric
F701: Polyfuse_Small; Fuse_1812_4532Metric
FB201, FB202, FB203, FB301, FB501, FB502, FB503, FB701, FB702, FB703: HH-1M1608-121JT; FB_0603_1608Metric
FB401, FB402: WE-742792122; FB_1206_3216Metric
FB704, FB705: HH-1M1608-221JT; FB_0603_1608Metric
H801, H802, H807, H808: MountingHole; MountingHole-10mm
H803, H804, H805, H806: MountingHole; MountingHole_2.5mm
IC201: W5300; QFP50P1600X1600X160-100N
IC301: ADIN1100BCPZ; ADIN1100
IC401: TPS26400RHFR; QFN50P400X500X100-25N-D
IC402: LDL112PV33R; SON95P300X300X100-7N-D
J201: RJ45; RJ45_Amphenol_RJHSE5380
J301, J401: Messtechnik_AK3001/2-KD-5,0; Messtechnik_AK3001_2-KD-5.0
J302: 09452812800
J402: Wuerth-694108301002; BarrelJack_Wuerth_6941xx301002
J501: Hirose_FH12-24S-0.5SH(55); Hirose_FH12-24S-0.5SH_1x24-1MP_P0.50mm_Horizontal
J701: USB_B_Micro; USB_Micro-B_Molex-105133-0001
J702: Conn_01x06; PinHeader_1x06_P2.54mm_Vertical_SMD_Pin1Left
L301: 100u; 744871101
L401: 470n; L_1206_3216Metric
L501: 3u3; FB_0603_1608Metric
L701: 744233121; WE-CNSW_08059
MOD401: AM3G-2403S-NZ; AM3G-NZ
MOD601, MOD602, MOD603, MOD604, MOD605, MOD606, MOD607: VL53L7CX-SATEL; VL53L5CX-SATEL
P201: RB1-125BAG1A; WIZNET_RB1-125BAG1A
Q601: AO3401A; SOT-23
R201, R207: 330; R_0603_1608Metric
R202, R203, R206, R209, R316, R319: 49R9; R_0603_1608Metric
R204, R205: 0R; R_0603_1608Metric
R208: 12k_1%; R_0603_1608Metric
R210, R703: 1M; R_0402_1005Metric
R211, R212: 75R; R_0603_1608Metric
R301, R302, R303, R304, R305, R306, R307, R308, R309, R310, R311, R313, R503, R504: 4k7; R_0402_1005Metric
R312: 1k5; R_0402_1005Metric
R314, R315: 10k2; R_0603_1608Metric
R317, R318: 5k1; R_0603_1608Metric
R320, R806, R807: 100; R_0603_1608Metric
R321, R405: 1M; R_1206_3216Metric
R401: 237k; R_0603_1608Metric
R402: 6k8; R_0603_1608Metric
R403: 10k; R_0603_1608Metric
R404: 53k6; R_0603_1608Metric
R501, R502, R601: 10k; R_0402_1005Metric
R701: 47k; R_0603_1608Metric
R702: 22k; R_0603_1608Metric
R704, R705: 22R; R_0402_1005Metric
R706: 49R9; R_0402_1005Metric
R707: 330R; R_0402_1005Metric
R801, R804, R809, R810: 330R; R_0603_1608Metric
R802, R803, R805, R808: 4k7; R_0603_1608Metric
RV301: S20K30; RV_Disc_D21.5mm_W4.3mm_P10mm
SW801: SW_Push; SW_Tactile_SPST_Angled_PTS645Vx83-2LFS
T301: 74930000
TP701, TP702: TestPoint; TestPoint_Pad_1.0x1.0mm
U301, U701: WE-TVS-82400102; SOT-23-6
U501: TLV74328PDBVR; SOT-23-5
U502: TLV75512PDBVR; SOT-23-5
U702: STM32U575ZITx; LQFP-144_20x20mm_P0.5mm
Y201, Y301: 7R-25.000MAAQ; Crystal_SMD_2016-4Pin_2.0x1.6mm
Y701: ABM8G-16.000MHZ-4Y-T3; Crystal_SMD_Abracon_ABM8G-4Pin_3.2x2.5mm

Connections:
2V8A: C512.2, C513.2, J501.21, L501.2
2V8D: C506.2, C508.2, FB503.1, L501.1, R501.2, R503.1, R504.1, U501.5 (OUT)
+1V2: C507.2, C509.2, FB501.2, U502.5 (OUT)
+1V8A: C206.2, C207.1, C214.2, FB201.2, IC201.7 (VCC1A8_1), IC201.17 (VCC1A8_2)
+1V8D: C202.2, C205.1, C208.1, C209.1, C212.2, C215.1, C223.1, C224.1, FB201.1, IC201.11 (VCC1V8_1), IC201.13 (1V8O), IC201.36 (VCC1V8_2), IC201.58 (VCC1V8_3), IC201.72 (VCC1V8_4), IC201.92 (VCC1V8_5), IC201.94 (VCC1V8_6)
+3.3VP: C601.1, C602.1, C603.1, C604.1, C606.1, C607.1, C608.1, MOD601.6 (AVDD), MOD601.7 (IOVDD), MOD602.6 (AVDD), MOD602.7 (IOVDD), MOD603.6 (AVDD), MOD603.7 (IOVDD), MOD604.6 (AVDD), MOD604.7 (IOVDD), MOD605.6 (AVDD), MOD605.7 (IOVDD), MOD606.6 (AVDD), MOD606.7 (IOVDD), MOD607.6 (AVDD), MOD607.7 (IOVDD), Q601.3 (D)
+3V3: C201.2, C203.2, C210.2, C211.1, C218.1, C222.1, C301.1, C302.2, C305.1, C306.1, C311.1, C312.1, C411.1, C412.1, C501.2, C502.2, C503.2, C504.2, C605.2, C702.2, C703.2, C704.2, C705.2, C706.2, C708.2, C710.2, C711.2, C712.2, C713.2, C714.2, C715.2, C716.2, C717.2, C719.2, C721.2, D804.2 (A), FB203.1, FB704.2, IC201.14 (VCC3V3_1), IC201.26 (VCC3V3_2), IC201.46 (VCC3V3_3), IC201.63 (VCC3V3_4), IC201.83 (VCC3V3_5), IC301.16 (AVDD_H_1), IC301.17 (AVDD_H_2), IC301.22 (AVDD_L), IC301.35 (VDDIO), IC402.4 (VOUT), J702.1, MOD401.6 (+Vout), Q601.2 (S), R201.2, R301.1, R302.1, R303.1, R304.1, R308.1, R310.1, R312.2, R801.2, U301.5, U501.1 (IN), U501.3 (EN), U502.1 (IN), U502.3 (EN), U702.6 (VBAT), U702.17 (VDD), U702.39 (VDD), U702.52 (VDD), U702.62 (VDD), U702.72 (VDD), U702.84 (VDD), U702.95 (VDDIO2), U702.106 (VDDUSB), U702.108 (VDD), U702.121 (VDD), U702.131 (VDDIO2), U702.144 (VDD)
+3V3A: C204.1, C216.2, C217.1, FB203.2, IC201.2 (VCC3A3), P201.R3 (CT), R204.1, R205.2
+5V-USB: C407.1, F701.2, IC402.1 (EN), IC402.6 (VIN)
/Camera/CAM-PWDN: J501.17, R502.2
/MCU/CAMXCLK: R706.2, U702.140 (PB9)
/MCU/SWCLK: J702.2, U702.109 (PA14)
/MCU/SWDIO: J702.4, U702.105 (PA13)
/MCU/SWO: J702.6, U702.133 (PB3)
/MCU/USB-5V: FB701.1, J701.1 (VBUS), U701.5
/MCU/USB-DN: L701.2, U702.103 (PA11)
/MCU/USB-DP: L701.3 (4), U702.104 (PA12)
/MCU/USB-GND: FB702.2, J701.5 (GND), U701.2
/MCU/USB-VBUS-DETECT: R701.1, R702.2, U702.101 (PA9)
/MCU/VBUS: C701.1, F701.1, FB701.2, R702.1
/MCU/nRST: J702.5, U702.25 (NRST)
/PowerSupply/CONV_IN: C408.1, L401.2, MOD401.2 (+Vin)
/PowerSupply/PROTECT-IN: C402.1, D402.1 (K), D403.1 (K), D405.1 (K), IC401.8 (IN), R401.1
/PowerSupply/SUPP_M: C401.2, FB401.1, J401.2, J402.2, J402.3
/PowerSupply/SUPP_P: C401.1, FB402.2, J401.1, J402.1
/Wiznet-W5300/RXIN: C226.2, IC201.6 (RXIN), P201.R8 (RD-), R202.1
/Wiznet-W5300/RXIP: C227.2, IC201.5 (RXIP), P201.R7 (RD+), R203.1
/Wiznet-W5300/TXON: C228.2, IC201.9 (TXON), P201.R2 (TD-), R206.2
/Wiznet-W5300/TXOP: C229.2, IC201.8 (TXOP), P201.R1 (TD+), R209.2
CAM-D0: J501.6, U702.96 (PC6)
CAM-D1: J501.4, U702.97 (PC7)
CAM-D2: J501.3, U702.141 (PE0)
CAM-D3: J501.5, U702.142 (PE1)
CAM-D4: J501.7, U702.3 (PE4)
CAM-D5: J501.9, U702.136 (PB6)
CAM-D6: J501.11, U702.4 (PE5)
CAM-D7: J501.13, U702.5 (PE6)
CAM-HSYNC: J501.16, U702.40 (PA4)
CAM-PCLK: C511.2, J501.8, U702.42 (PA6)
CAM-SCL: J501.20, R504.2, U702.26 (PC0)
CAM-SDA: J501.22, R503.2, U702.27 (PC1)
CAM-VSYNC: J501.18, U702.137 (PB7)
CAM-XCLK: J501.12, R706.1, R707.1
CAM-nRESET: C505.1, J501.19, R501.1, U702.28 (PC2)
CAMGNDA: C512.1, C513.1, FB502.1, J501.23
ETH-BUS-ADDR0: IC201.57 (ADDR0), U702.10 (PF0)
ETH-BUS-ADDR1: IC201.56 (ADDR1), U702.11 (PF1)
ETH-BUS-ADDR2: IC201.55 (ADDR2), U702.12 (PF2)
ETH-BUS-ADDR3: IC201.54 (ADDR3), U702.13 (PF3)
ETH-BUS-ADDR4: IC201.53 (ADDR4), U702.14 (PF4)
ETH-BUS-ADDR5: IC201.52 (ADDR5), U702.15 (PF5)
ETH-BUS-ADDR6: IC201.51 (ADDR6), U702.50 (PF12)
ETH-BUS-ADDR7: IC201.50 (ADDR7), U702.53 (PF13)
ETH-BUS-ADDR8: IC201.49 (ADDR8), U702.54 (PF14)
ETH-BUS-ADDR9: IC201.48 (ADDR9), U702.55 (PF15)
ETH-BUS-DATA0: IC201.45 (DATA0), U702.85 (PD14)
ETH-BUS-DATA1: IC201.44 (DATA1), U702.86 (PD15)
ETH-BUS-DATA2: IC201.43 (DATA2), U702.114 (PD0)
ETH-BUS-DATA3: IC201.42 (DATA3), U702.115 (PD1)
ETH-BUS-DATA4: IC201.41 (DATA4), U702.58 (PE7)
ETH-BUS-DATA5: IC201.40 (DATA5), U702.59 (PE8)
ETH-BUS-DATA6: IC201.39 (DATA6), U702.60 (PE9)
ETH-BUS-DATA7: IC201.38 (DATA7), U702.63 (PE10)
ETH-BUS-nCS: IC201.62 (/CS), U702.123 (PD7)
ETH-BUS-nINT: IC201.65 (/INT), U702.2 (PE3)
ETH-BUS-nRD: IC201.61 (/RD), U702.118 (PD4)
ETH-BUS-nRESET: IC201.66 (/RESET), U702.1 (PE2)
ETH-BUS-nWR: IC201.60 (/WR), U702.119 (PD5)
ETH-LINKLED: IC201.90 (LINKLED), P201.L4, R804.2
ETH-MEDIA_SEL: IC201.22 (TEST_MODE0), U702.44 (PC4)
ETHGNDA: C204.2, C206.1, C207.2, C213.2, C214.1, C216.1, C217.2, C219.2, C225.1, FB202.2, IC201.4 (GNDA_1), IC201.10 (GNDA_2), IC201.16 (GNDA_3), P201.S1, P201.S2
GND: C201.1, C202.1, C203.1, C205.2, C208.2, C209.2, C210.1, C211.2, C212.1, C215.2, C218.2, C220.2, C221.1, C222.2, C223.2, C224.2, C301.2, C302.1, C303.2, C304.2, C305.2, C306.2, C307.2, C308.1, C309.2, C310.2, C311.2, C312.2, C315.1, C407.2, C409.2, C410.2, C411.2, C412.2, C501.1, C502.1, C503.1, C504.1, C505.2, C506.1, C507.1, C508.1, C509.1, C510.1, C511.1, C514.2, C601.2, C602.2, C603.2, C604.2, C606.2, C607.2, C608.2, C701.2, C702.1, C703.1, C704.1, C705.1, C706.1, C707.2, C708.1, C709.1, C710.1, C711.1, C712.1, C713.1, C714.1, C715.1, C716.1, C717.1, C719.1, C721.1, C722.2, C723.1, D801.1 (K), D803.1 (K), D805.1 (K), D806.1 (K), D807.1 (K), D808.1 (K), FB202.1, FB502.2, FB702.1, FB705.2, IC201.12 (GND_1), IC201.15 (GND_2), IC201.18 (BIT16EN), IC201.19 (TEST_MODE3), IC201.20 (TEST_MODE2), IC201.21 (TEST_MODE1), IC201.23 (OP_MODE0_1), IC201.24 (OP_MODE0_2), IC201.25 (OP_MODE2), IC201.27 (GND_3), IC201.37 (GND_4), IC201.47 (GND_5), IC201.59 (GND_6), IC201.64 (GND_7), IC201.73 (GND_8), IC201.84 (GND_9), IC201.93 (GND_10), IC201.97 (GND_11), IC301.41 (GND), IC402.2 (GND), IC402.7 (EP), J501.10, J702.3, MOD401.7 (-Vout), MOD601.8 (GND), MOD602.8 (GND), MOD603.8 (GND), MOD604.8 (GND), MOD605.8 (GND), MOD606.8 (GND), MOD607.8 (GND), R207.1, R305.1, R306.1, R307.1, R309.1, R311.1, R313.1, R405.2, R502.1, R701.2, R703.2, R707.2, R802.1, R805.2, R808.2, SW801.2, U301.2, U501.2 (GND), U502.2 (GND), U702.16 (VSS), U702.38 (VSS), U702.51 (VSS), U702.61 (VSS), U702.71 (VSS), U702.83 (VSS), U702.94 (VSS), U702.107 (VSS), U702.120 (VSS), U702.130 (VSS), U702.143 (VSS), Y201.2, Y201.4, Y301.2, Y301.4, Y701.2, Y701.4
GNDPWR: C318.2, C319.2, C402.2, C403.2, C404.2, C405.2, C406.2, C408.2, C409.1, D401.2 (A), D404.2 (A), D406.2 (A), FB401.2, IC401.13 (MODE), IC401.15 (RTN), IC401.17 (GND), IC401.25 (EP), MOD401.1 (-Vin), R321.2, R403.2, R404.2, R405.1
MCU-STATUS-1: R809.2, U702.88 (PG3)
MCU-STATUS-2: R810.2, U702.135 (PB5)
MII-CRS: IC201.81 (MII_CRS), IC301.4 (LINK_ST/PHYAD_2), R313.2, U702.34 (PA0)
MII-RXCLK: IC201.71 (MII_RXC), IC301.32 (MACIF_SEL0/RX_CLK), R302.2
MII-RXD0: IC201.75 (MII_RXD0), IC301.31 (~TX2P4_EN/RXD_0), R306.2
MII-RXD1: IC201.76 (MII_RXD1), IC301.30 (MS_SEL/RXD_1), R304.2, R305.2
MII-RXD2: IC201.77 (MII_RXD2), IC301.29 (PHYAD_0/RXD_2), R307.2, R308.2
MII-RXD3: IC201.78 (MII_RXD3), IC301.28 (PHYAD_1/RXD_3), R309.2, R310.2
MII-RXDV: IC201.74 (MII_RXDV), IC301.33 (~SWPD_EN/RX_DV), R301.2
MII-TXCLK: IC201.82 (MII_TXC), IC301.38 (TX_CLK)
MII-TXD0: IC201.85 (/SPDLED(MII_TXD0)), IC301.39 (TXD_0)
MII-TXD1: IC201.86 (/FDXLED(MII_TXD1)), IC301.40 (TXD_1)
MII-TXD2: IC201.87 (/COLLED(MLL_TXD2)), IC301.1 (TXD_2)
MII-TXD3: IC201.88 (/RXLED(MII_TXD3)), IC301.2 (TXD_3/MEDIA_CNV), R311.2
MII-TXEN: IC201.89 (/TXLED(MII_TXEN)), IC301.37 (TX_EN)
unnamed: C213.1, R202.2, R203.2, R204.2
unnamed: C219.1, R205.1, R206.1, R209.1
unnamed: C225.2, R211.2, R212.2
unnamed: C226.1, J201.6
unnamed: C227.1, J201.3
unnamed: C228.1, J201.2
unnamed: C229.1, J201.1
unnamed: C313.2, R316.2, R317.2
unnamed: C314.1, R318.2, R319.2
unnamed: C316.2, F301.1, L301.4
unnamed: C317.2, F302.1, L301.1
unnamed: C318.1, R320.2
unnamed: C319.1, FB301.2, R321.1
unnamed: C707.1, FB703.2, R703.1
unnamed: D405.2 (A), F401.2
unnamed: D801.2 (A), R801.1
unnamed: D802.1 (A), R803.2
unnamed: D803.2 (A), R802.2, R803.1
unnamed: D804.1 (K), R804.1
unnamed: D805.2 (A), R806.2
unnamed: D806.2 (A), R807.2
unnamed: D807.2 (A), R809.1
unnamed: D808.2 (A), R810.1
unnamed: F401.1, FB402.1
unnamed: FB301.1, J302.MH1, J302.MH2, J302.MH3, J302.MH4
unnamed: IC201.1 (RSET_BG), R208.2
unnamed: C221.2, IC201.95 (XTLN), R210.1, Y201.3
unnamed: C220.1, IC201.96 (XTLP), R210.2, Y201.1
unnamed: C310.1, IC301.19 (CEXT_2)
unnamed: C309.1, IC301.20 (CEXT_3)
unnamed: C303.1, C304.1, IC301.23 (DLDO_1P1), IC301.24 (DVDD_1P1)
unnamed: IC301.34 (MAC_IFSEL1/RX_ER), R303.2
unnamed: IC301.13 (RXN), R314.2, R318.1
unnamed: IC301.14 (RXP), R315.1, R317.1
unnamed: IC301.12 (TXN), R315.2, R319.1
unnamed: IC301.15 (TXP), R314.1, R316.1
unnamed: C308.2, IC301.8 (XTAL_I/CLK_IN), Y301.3
unnamed: C307.1, IC301.9 (XTAL_O), Y301.1
unnamed: C403.1, IC401.20 (DVDT)
unnamed: IC401.19 (ILIM), R404.1
unnamed: IC401.12 (OVP), R402.2, R403.1
unnamed: IC401.10 (UVLO), R401.2, R402.1
unnamed: J201.4, J201.5, R212.1
unnamed: J201.7, J201.8, R211.1
unnamed: F301.2, J301.1, J302.1 (BI_DA+)
unnamed: F302.2, J301.2, J302.2 (BI_DA-)
unnamed: C514.1, FB503.2, J501.14
unnamed: C510.2, FB501.1, J501.15
unnamed: J701.3 (D+), L701.4 (3), U701.1, U701.6
unnamed: J701.2 (D-), L701.1, U701.3, U701.4
unnamed: FB703.1, J701.6 (Shield)
unnamed: C410.1, MOD401.8 (Cs)
unnamed: P201.L3, R201.1
unnamed: C605.1, Q601.1 (G), R601.2
unnamed: R207.2, R208.1
unnamed: C313.1, T301.1 (N1), U301.3, U301.4
unnamed: C315.2, T301.5 (N1/N4)
unnamed: R320.1, T301.3 (N3_1), T301.4 (N2_1)
unnamed: C316.1, T301.6 (N2_2)
unnamed: C317.1, T301.7 (N3_2)
unnamed: C314.2, T301.2 (N4), U301.1, U301.6
unnamed: TP702.1, U702.36 (PA2)
unnamed: TP701.1, U702.37 (PA3)
unnamed: R705.1, U702.66 (PE13)
unnamed: R704.1, U702.68 (PE15)
unnamed: C723.2, U702.23 (PH0), Y701.1
unnamed: C722.1, U702.24 (PH1), Y701.3
unnamed: C709.2, U702.70 (VCAP)
unnamed: C718.2, C720.2, FB704.1, U702.32 (VREF+), U702.33 (VDDA)
unnamed: C718.1, C720.1, FB705.1, U702.30 (VSSA), U702.31 (VREF-)
PUSHBUTTON: SW801.1, U702.47 (PB1)
PWR_HV: C404.1, C405.1, C406.1, D406.1 (K), D802.3 (K), IC401.23 (OUT), L401.1
SPE-LED-0: IC301.3 (LED_0), R805.1, R806.1
SPE-LED-1: IC301.6 (LED_1), R807.1, R808.1
SPE-MDC: IC301.27 (MDC), R705.2
SPE-MDIO: IC301.26 (MDIO), R704.2, U702.67 (PE14)
SPE-nINT: IC301.25 (~INT), R312.1, U702.64 (PE11)
SPE-nRESET: IC301.5 (~RESET), U702.69 (PB10)
SPoE-1: D401.1 (K), D402.2 (A), L301.3, RV301.2
SPoE-2: D403.2 (A), D404.1 (K), L301.2, RV301.1
ToF-1-LPn: MOD601.5 (LPn), U702.73 (PB12)
ToF-2-LPn: MOD602.5 (LPn), U702.110 (PA15)
ToF-3-LPn: MOD603.5 (LPn), U702.111 (PC10)
ToF-4-LPn: MOD604.5 (LPn), U702.112 (PC11)
ToF-5-LPn: MOD605.5 (LPn), U702.134 (PB4)
ToF-6-LPn: MOD606.5 (LPn), U702.138 (PH3)
ToF-7-LPn: MOD607.5 (LPn), U702.139 (PB8)
ToF-I2C-1-RST: MOD601.2 (I2C_RST), MOD602.2 (I2C_RST), MOD603.2 (I2C_RST), MOD604.2 (I2C_RST), U702.80 (PD11)
ToF-I2C-1-SCL: MOD601.4 (SCL), MOD602.4 (SCL), MOD603.4 (SCL), MOD604.4 (SCL), U702.81 (PD12)
ToF-I2C-1-SDA: MOD601.3 (SDA), MOD602.3 (SDA), MOD603.3 (SDA), MOD604.3 (SDA), U702.82 (PD13)
ToF-I2C-2-RST: MOD605.2 (I2C_RST), MOD606.2 (I2C_RST), MOD607.2 (I2C_RST), U702.127 (PG12)
ToF-I2C-2-SCL: MOD605.4 (SCL), MOD606.4 (SCL), MOD607.4 (SCL), U702.129 (PG14)
ToF-I2C-2-SDA: MOD605.3 (SDA), MOD606.3 (SDA), MOD607.3 (SDA), U702.128 (PG13)
ToF-nPWDN: R601.1, U702.113 (PC12)
