wiznetmaker-contest/W5300-Camera-ToF-3D/hardware/SinglePair-Eth-Gateway/SinglePair-Eth-Gateway.kicad_pcb

## KiCad design hardware/SinglePair-Eth-Gateway/SinglePair-Eth-Gateway.kicad_pcb (2023-08-10)

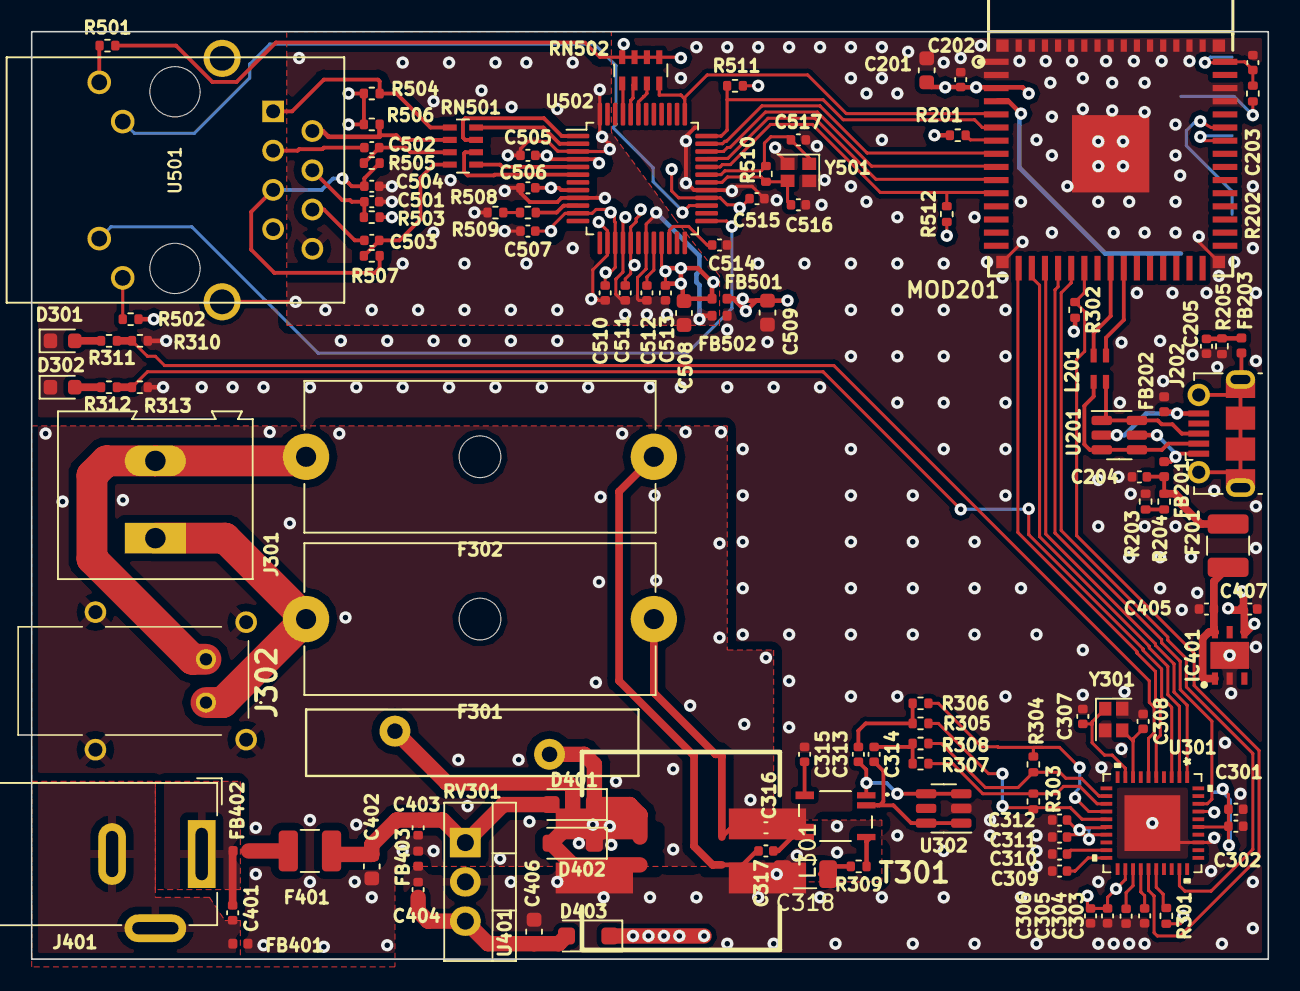
[picture p50: board SinglePair-Eth-Gateway.kicad_pcb from above]

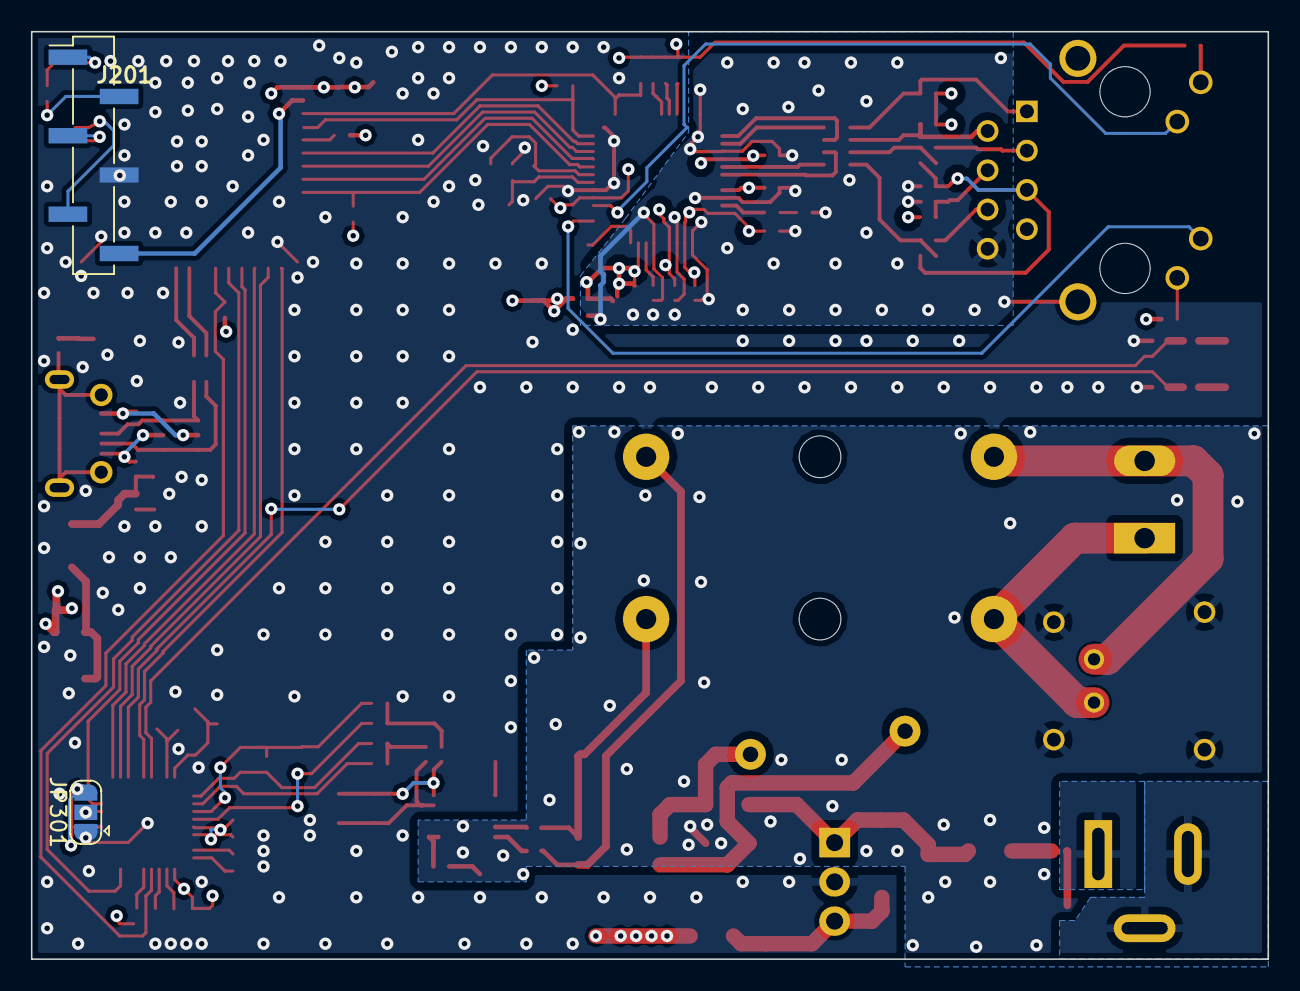
[picture p51: board SinglePair-Eth-Gateway.kicad_pcb from below]

Board: 4 copper layers, 80.0 x 60.0 mm, 116 parts (2 on the bottom side), 94 nets.

Parts:
C201, C402, C406, C508, C509: 10u; C_0603_1608Metric
C202, C204, C301, C303, C306, C310, C312, C315, C401, C403, C404, C505, C506, C507, C510, C511, C513, C514, C515: 100n; C_0402_1005Metric
C203, C309, C316, C317, C405, C407: 1u; C_0402_1005Metric
C205: 4n7; C_0402_1005Metric
C302, C305, C311, C504: 10n; C_0402_1005Metric
C304: 680n; C_0402_1005Metric
C307, C308, C516, C517: 13p; C_0402_1005Metric
C313, C314: 220n; C_0402_1005Metric
C318: 1n; C_1206_3216Metric
C501: 22n; C_0402_1005Metric
C502, C503: 6n8; C_0402_1005Metric
C512: 4u7; C_0402_1005Metric
D301, D302: LED; LED_0603_1608Metric
D401, D402, D403: PMEG6010CEH; D_SOD-123F
F201: Polyfuse_Small; Fuse_1210_3225Metric
F301, F302: Fuse; Fuseholder_Cylinder-5x20mm_Schurter_0031_8201_Horizontal_Op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
F401: Polyfuse; Fuse_1210_3225Metric
FB201, FB202, FB203, FB401, FB402, FB403, FB501, FB502: HH-1M1005-221JT; L_0402_1005Metric
IC401: LDL112PV33R; SON95P300X300X100-7N-D
J201: Conn_01x06_Pin; PinHeader_1x06_P2.54mm_Vertical_SMD_Pin1Left
J202: USB_B_Micro; USB_Micro-B_Molex-105017-0001
J301: Screw_Terminal_01x02; TerminalBlock_Altech_AK300-2_P5.00mm
J302: 09452812800
J401: Wuerth-694108301002; BarrelJack_Wuerth_6941xx301002
JP301: SolderJumper_3_Open; SolderJumper-3_P1.3mm_Open_RoundedPad1.0x1.5mm
L201: 744233121; WE-CNSW_08059
L301: 100u; 744871101
MOD201: ESP32-S3-MINI-1-N8; XCVR_ESP32-S3-MINI-1-N8
R201, R202, R511, R512: 10k; R_0402_1005Metric
R203: 47k; R_0402_1005Metric
R204: 22k; R_0402_1005Metric
R205, R510: 1M; R_0402_1005Metric
R301, R302: 1k5; R_0402_1005Metric
R303, R304: 10R2; R_0402_1005Metric
R305, R308, R504, R505, R506, R507: 49R9; R_0402_1005Metric
R306, R307: 5R1; R_0402_1005Metric
R309, R311, R312: 100R; R_0402_1005Metric
R310, R313: 4k7; R_0402_1005Metric
R501, R502: 330R; R_0402_1005Metric
R503: 10R; R_0402_1005Metric
R508: 300; R_0402_1005Metric
R509: 12k_1%; R_0402_1005Metric
RN501: 33R; R_Array_Concave_4x0603
RN502: 10k; R_Array_Concave_4x0603
RV301: S20K30; RV_Disc_D21.5mm_W4.3mm_P10mm
T301: 74930000
U201, U302: WE-TVS-82400102; SOT-23-6
U301: ADIN1110BCPZ; ADIN1110
U401: VXO7803-1000; TO-220-3_Vertical
U501: 7499010211A
U502: W5500; LQFP-48_7x7mm_P0.5mm
Y301, Y501: 830108212509; Crystal_SMD_2016-4Pin_2.0x1.6mm

Connections:
+3V3: C201.2, C202.2, C301.1, C302.1, C305.1, C306.1, C311.1, C312.1, C407.1, C509.1, C515.1, D403.1 (K), FB501.1, IC401.4 (VOUT), J201.2, JP301.3 (B), MOD201.3 (3V3), R201.1, R202.1, R301.2, R302.2, R501.2, R502.2, R511.2, R512.1, RN502.5 (R4.2), RN502.6 (R3.2), RN502.7 (R2.2), RN502.8 (R1.2), U301.16 (AVDD_H), U301.17 (AVDD_H), U301.22 (AVDD_L), U301.35 (VDDIO), U502.28 (VDD)
+3V3A: C505.2, C506.2, C507.2, C508.1, C510.2, C511.2, C513.2, FB501.2, R503.2, R504.1, R506.1, U502.4 (AVDD), U502.8 (AVDD), U502.11 (AVDD), U502.15 (AVDD), U502.17 (AVDD), U502.21 (AVDD)
+5V-USB: C405.1, F201.2, IC401.1 (EN), IC401.6 (VIN)
+24V: C402.1, C403.1, D401.2 (A), F401.2, U401.1 (IN)
/ADIN1110/LED-0: R312.1, R313.1, U301.3 (LED_0)
/ADIN1110/LED-1: R310.1, R311.1, U301.6 (LED_1)
/ESP32-S3/BOOT: J201.6, MOD201.4 (IO0)
/ESP32-S3/EN: C203.1, J201.1, MOD201.45 (EN), R202.2
/ESP32-S3/RXD0: J201.5, MOD201.40 (RXD0)
/ESP32-S3/TXD0: J201.3, MOD201.39 (TXD0)
/ESP32-S3/USB-5V: FB201.1, J202.1 (VBUS), U201.5
/ESP32-S3/USB-DM: L201.2, MOD201.23 (IO19)
/ESP32-S3/USB-DP: L201.3 (4), MOD201.24 (IO20)
/ESP32-S3/USB-GND: FB202.2, J202.5 (GND), U201.2
/ESP32-S3/USB-VBUS: R203.1, R204.2
/ESP32-S3/VBUS: C204.1, F201.1, FB201.2, R204.1
/PowerSupply/GND-HV: C401.2, FB401.1, J401.2, J401.3
/PowerSupply/PWR-HV: C401.1, FB402.2, J401.1
/Wiznet-W5500/ACTLED: U501.10 (D2), U502.27 (ACTLED)
/Wiznet-W5500/LINKLED: U501.11 (D4), U502.25 (LINKLED)
/Wiznet-W5500/RXIN: RN501.1 (R1.1), U502.5 (RXN)
/Wiznet-W5500/RXIP: RN501.2 (R2.1), U502.6 (RXP)
/Wiznet-W5500/RXN: C503.2, R507.1, RN501.8 (R1.2)
/Wiznet-W5500/RXP: C502.2, R505.1, RN501.7 (R2.2)
/Wiznet-W5500/TXN: R506.2, RN501.6 (R3.2), U501.2 (TD-)
/Wiznet-W5500/TXON: RN501.3 (R3.1), U502.1 (TXN)
/Wiznet-W5500/TXOP: RN501.4 (R4.1), U502.2 (TXP)
/Wiznet-W5500/TXP: R504.2, RN501.5 (R4.2), U501.1 (TD+)
ETH-MISO: MOD201.9 (IO5), U502.34 (MISO)
ETH-MOSI: MOD201.8 (IO4), U502.35 (MOSI)
ETH-SCK: MOD201.10 (IO6), U502.33 (SCLK)
ETH-nCS: MOD201.11 (IO7), R512.2, U502.32 (~SCS)
ETH-nINT: MOD201.6 (IO2), R511.1, U502.36 (~INT)
ETH-nRST: MOD201.5 (IO1), RN502.4 (R4.1), U502.37 (~RST)
ETHGNDA: C501.2, C504.2, C505.1, C506.1, C507.1, C508.2, C510.1, C511.1, C512.2, C513.1, FB502.2, R508.1, U501.8 (C1), U501.CASE@1, U501.CASE@2, U502.3 (AGND), U502.9 (AGND), U502.14 (AGND), U502.16 (AGND), U502.19 (AGND), U502.48 (AGND)
GND: C201.1, C202.1, C203.2, C204.2, C205.2, C301.2, C302.2, C303.2, C304.2, C305.2, C306.2, C307.2, C308.1, C309.2, C310.2, C311.2, C312.2, C315.1, C404.2, C405.2, C406.2, C407.2, C509.2, C514.2, C515.2, C516.1, C517.2, D301.1 (K), D302.1 (K), FB202.1, FB403.1, FB502.1, IC401.2 (GND), IC401.7 (EP), J201.4, JP301.1 (A), MOD201.GND, R203.2, R205.2, R310.2, R313.2, U301.33 (SWPD_ENB), U301.41 (EPAD), U302.2, U401.2 (GND), U502.29 (GND), Y301.2, Y301.4, Y501.2, Y501.4
GNDPWR: C318.2, C402.2, C403.2, D402.1 (K), FB401.2, FB403.2, J302.MH1, J302.MH2, J302.MH3, J302.MH4
unnamed: C205.1, FB203.2, R205.1
unnamed: C313.2, R305.2, R306.2
unnamed: C314.1, R307.2, R308.2
unnamed: C316.1, F301.1, L301.2
unnamed: C317.2, F302.1, L301.3
unnamed: C318.1, R309.2
unnamed: D301.2 (A), R311.2
unnamed: D302.2 (A), R312.2
unnamed: C404.1, C406.1, D403.2 (A), U401.3 (OUT)
unnamed: F401.1, FB402.1
unnamed: J202.3 (D+), L201.4 (3), U201.1, U201.6
unnamed: J202.2 (D-), L201.1, U201.3, U201.4
unnamed: FB203.1, J202.6 (Shield)
unnamed: F301.2, J301.1, J302.1 (BI_DA+)
unnamed: F302.2, J301.2, J302.2 (BI_DA-)
unnamed: JP301.2 (C), U301.37 (SPI_CFG1)
unnamed: MOD201.7 (IO3), R201.2
unnamed: R508.2, R509.1
unnamed: RN502.1 (R1.1), U502.45 (PMODE0)
unnamed: RN502.2 (R2.1), U502.44 (PMODE1)
unnamed: RN502.3 (R3.1), U502.43 (PMODE2)
unnamed: C313.1, T301.1 (N1), U302.3, U302.4
unnamed: C315.2, T301.5 (N1/N4)
unnamed: R309.1, T301.3 (N3_1), T301.4 (N2_1)
unnamed: C316.2, T301.6 (N2_2)
unnamed: C317.1, T301.7 (N3_2)
unnamed: C314.2, T301.2 (N4), U302.1, U302.6
unnamed: C310.1, U301.19 (CEXT_2)
unnamed: C309.1, U301.20 (CEXT_3)
unnamed: C304.1, U301.23 (DLDO_1P1)
unnamed: C303.1, U301.24 (DVDD_1P1)
unnamed: R303.2, R307.1, U301.13 (RXN)
unnamed: R304.1, R306.1, U301.14 (RXP)
unnamed: R301.1, U301.26 (TEST1)
unnamed: R304.2, R308.1, U301.12 (TXN)
unnamed: R303.1, R305.1, U301.15 (TXP)
unnamed: C308.2, U301.8 (XTAL_I/CLK_IN), Y301.3
unnamed: C307.1, U301.9 (XTAL_O), Y301.1
unnamed: R501.1, U501.9 (D1)
unnamed: R502.1, U501.12 (D3)
unnamed: C504.1, R505.2, R507.2, U501.5 (RCT)
unnamed: C502.1, U501.3 (RD+)
unnamed: C503.1, U501.6 (RD-)
unnamed: C501.1, R503.1, U501.4 (TCT)
unnamed: C514.1, U502.22 (1V2O)
unnamed: R509.2, U502.10 (EXRES1)
unnamed: C512.1, U502.20 (TOCAP)
unnamed: C516.2, R510.1, U502.30 (XI/CLKIN), Y501.3
unnamed: C517.1, R510.2, U502.31 (XO), Y501.1
SPE-SCK: MOD201.19 (IO15), U301.38 (SCLK)
SPE-SDI: MOD201.18 (IO14), U301.1 (SDI)
SPE-SDO: MOD201.17 (IO13), U301.2 (SDO/SPI_CFG0)
SPE-nCS: MOD201.20 (IO16), U301.29 (CS_N)
SPE-nINT: MOD201.21 (IO17), R302.1, U301.25 (INT_N)
SPE-nRST: MOD201.16 (IO12), U301.5 (RESET_N)
SPoE-1: D401.1 (K), L301.1, RV301.2
SPoE-2: D402.2 (A), L301.4, RV301.1
