wiznetmaker-contest/W5300-Camera-ToF-3D/software/ToffeeCam/src/ToffeCam.ioc

Mcu.UserName=STM32U575ZITx
PA11.Signal=USB_OTG_FS_DM
PA12.Signal=USB_OTG_FS_DP
PA2.Signal=USART2_TX
PA3.Signal=USART2_RX
PA4.GPIO_Label=CAM_HSYNC
PA4.Signal=DCMI_HSYNC
PA6.GPIO_Label=CAM_PCLK
PA6.Signal=DCMI_PIXCLK
PA9.Signal=USB_OTG_FS_VBUS
PB1.GPIO_Label=BUTTON
PB1.Signal=GPXTI1
PB10.GPIO_Label=SPE_nRESET
PB10.Signal=GPIO_Output
PB12.GPIO_Label=TOF_1_LPn
PB12.Signal=GPIO_Output
PB13.Signal=I2C2_SCL
PB14.Signal=I2C2_SDA
PB5.GPIO_Label=MCU-STATUS-2
PB5.Signal=GPIO_Output
PB6.GPIO_Label=CAM_D5
PB6.Signal=DCMI_D5
PB7.GPIO_Label=CAM_VSYNC
PB7.Signal=DCMI_VSYNC
PB8.GPIO_Label=TOF_7_LPn
PB8.Signal=GPIO_Output
PB9.GPIO_Label=CAM_XCLK
PB9.Signal=S_TIM4_CH4
PC0.GPIO_Label=CAM_I2C_SCL
PC0.Signal=I2C3_SCL
PC1.GPIO_Label=CAM_I2C_SDA
PC1.Signal=I2C3_SDA
PC10.GPIO_Label=TOF_3_LPn
PC10.Signal=GPIO_Output
PC11.GPIO_Label=TOF_4_LPn
PC11.Signal=GPIO_Output
PC12.GPIO_Label=TOF_nPWDN
PC12.Signal=GPIO_Output
PC3.GPIO_Label=CAM_nRESET
PC3.Signal=GPIO_Output
PC4.GPIO_Label=ETH_MEDIA_SELECT
PC4.Signal=GPIO_Output
PC6.GPIO_Label=CAM_D0
PC6.Signal=DCMI_D0
PC7.GPIO_Label=CAM_D1
PC7.Signal=DCMI_D1
PD0.GPIO_Label=ETH_BUS_D2
PD0.Signal=FMC_D2_DA2
PD1.GPIO_Label=ETH_BUS_D3
PD1.Signal=FMC_D3_DA3
PD11.GPIO_Label=TOF_I2C1_RST
PD11.Signal=GPIO_Output
PD12.Signal=I2C4_SCL
PD13.Signal=I2C4_SDA
PD14.GPIO_Label=ETH_BUS_D0
PD14.Signal=FMC_D0_DA0
PD15.GPIO_Label=ETH_BUS_D1
PD15.Signal=FMC_D1_DA1
PD4.GPIO_Label=ETH_BUS_nRD
PD4.Signal=FMC_NOE
PD5.GPIO_Label=ETH_BUS_nWR
PD5.Signal=FMC_NWE
PD7.GPIO_Label=ETH_BUS_nCS
PD7.Signal=FMC_NE1
PE0.GPIO_Label=CAM_D2
PE0.Signal=DCMI_D2
PE1.GPIO_Label=CAM_D3
PE1.Signal=DCMI_D3
PE10.GPIO_Label=ETH_BUS_D7
PE10.Signal=FMC_D7_DA7
PE13.GPIO_Label=SPE_SPI1_SCK
PE13.Signal=SPI1_SCK
PE14.GPIO_Label=SPE_SPI1_MISO
PE14.Signal=SPI1_MISO
PE15.GPIO_Label=SPE_SPI1_MOSI
PE15.Signal=SPI1_MOSI
PE2.GPIO_Label=ETH_BUS_nRST
PE2.Signal=GPIO_Output
PE3.GPIO_Label=ETH_BUS_nINT
PE3.Signal=GPXTI3
PE4.GPIO_Label=CAM_D4
PE4.Signal=DCMI_D4
PE5.GPIO_Label=CAM_D6
PE5.Signal=DCMI_D6
PE6.GPIO_Label=CAM_D7
PE6.Signal=DCMI_D7
PE7.GPIO_Label=ETH_BUS_D4
PE7.Signal=FMC_D4_DA4
PE8.GPIO_Label=ETH_BUS_D5
PE8.Signal=FMC_D5_DA5
PE9.GPIO_Label=ETH_BUS_D6
PE9.Signal=FMC_D6_DA6
PF0.Signal=FMC_A0
PF1.Signal=FMC_A1
PF10.GPIO_Label=DUMMY5
PF10.Signal=GPIO_Output
PF12.Signal=FMC_A6
PF13.Signal=FMC_A7
PF14.Signal=FMC_A8
PF15.Signal=FMC_A9
PF2.Signal=FMC_A2
PF3.Signal=FMC_A3
PF4.Signal=FMC_A4
PF5.Signal=FMC_A5
PF6.GPIO_Label=DUMMY1
PF6.Signal=GPIO_Output
PF7.GPIO_Label=DUMMY2
PF7.Signal=GPIO_Output
PF8.GPIO_Label=DUMMY3
PF8.Signal=GPIO_Output
PF9.GPIO_Label=DUMMY4
PF9.Signal=GPIO_Output
PG12.GPIO_Label=TOF_I2C2_RST
PG12.Signal=GPIO_Output
PG13.Signal=I2C1_SDA
PG14.Signal=I2C1_SCL
PG3.GPIO_Label=MCU_STATUS_1
PG3.Signal=GPIO_Output
PH3-BOOT0.GPIO_Label=TOF_6_LPn
PH3-BOOT0.Signal=GPIO_Output
