wiznetmaker-contest/W5300-Camera-ToF-3D/software/ToffeeCam/src/wiznet_port/wiznet_port.h

//
// Created by jarojuda on 02.09.23.
//

#ifndef TOFFECAM_WIZNET_PORT_H
#define TOFFECAM_WIZNET_PORT_H

#include <wizchip_conf.h>
#include <w5x00_bus.h>
#include <w5x00_network.h>
#include <w5x00_timer.h>


#endif //TOFFECAM_WIZNET_PORT_H
