wiznetmaker-contest/W5300-Camera-ToF-3D/software/ToffeeCam/src/wiznet/io_library/ethernet/wiznet_io_library_ethernet.h

//
// Created by jarojuda on 03.09.23.
//

#ifndef WIZNET_IO_LIBRARY_ETHERNET_H
#define WIZNET_IO_LIBRARY_ETHERNET_H

#include "io_library/ethernet/socket.h"
#include "io_library/ethernet/W5100/w5100.h"
#include "io_library/ethernet/W5100S/w5100s.h"
#include "io_library/ethernet/W5200/w5200.h"
#include "io_library/ethernet/W5300/w5300.h"
#include "io_library/ethernet/W5500/w5500.h"

#endif //WIZNET_IO_LIBRARY_ETHERNET_H
