wiznetmaker-contest/W5300-Camera-ToF-3D/software/ToffeeCam/src/wiznet_port/w5x00_bus.h

/**
 * Copyright (c) 2023 WIZnet Co.,Ltd
 *
 * SPDX-License-Identifier: BSD-3-Clause
 */

#ifndef _W5X00_BUS_H_
#define _W5X00_BUS_H_

#ifdef __cplusplus
extern "C"
{
#endif

#include "main.h"
/**
 * ----------------------------------------------------------------------------------------------------
 * Includes
 * ----------------------------------------------------------------------------------------------------
 */

/**
 * ----------------------------------------------------------------------------------------------------
 * Macros
 * ----------------------------------------------------------------------------------------------------
 */

/**
 * ----------------------------------------------------------------------------------------------------
 * Variables
 * ----------------------------------------------------------------------------------------------------
 */

/**
 * ----------------------------------------------------------------------------------------------------
 * Functions
 * ----------------------------------------------------------------------------------------------------
 */

void wizchip_initialize(void);


#ifdef __cplusplus
}
#endif

#endif /* _W5X00_BUS_H_ */
