wiznetmaker-contest/W5300-Camera-ToF-3D/(commit log)

2023-08-10 Second hardware prototype
    [ADIN1110.kicad_sch, Camera.kicad_sch, ESP32-S3.kicad_sch, Ethernet-10BASE-T1L.kicad_sch, MCU.kicad_sch, PowerSupply.kicad_sch, SinglePair-Eth-Gateway.kicad_pcb, SinglePair-Eth-Gateway.kicad_sch]
2023-08-10 Initial software
    [st_nucleo_u5.cfg]
2023-08-12 Clean schematics
    [Camera.kicad_sch, Ethernet-10BASE-T1L.kicad_sch, MCU.kicad_sch, Panel.kicad_sch, PowerSupply.kicad_sch, ToF-Sensors-Matrix.kicad_sch, ToffeeCam.kicad_pcb, ToffeeCam.kicad_sch]
2023-08-13 Add drawings
    [ToF-Matrix.scad]
2023-08-17 Docs up to date
    [BOM.ods, Ethernet-10BASE-T1L.kicad_sch, MCU.kicad_sch, Panel.kicad_sch, ToffeeCam.csv, Wiznet-W5300.kicad_sch]
2023-08-20 Docs for Wiznet's contest
    [Ethernet-10BASE-T1L.kicad_sch, ToffeeCam.csv]
