wiznetmaker-contest/W5300-Camera-ToF-3D/(notices)

Notices in the files:
software/ToffeeCam/src/Core/Inc/main.h:
Copyright (c) 2023 STMicroelectronics.
All rights reserved.
This software is licensed under terms that can be found in the LICENSE file
software/ToffeeCam/src/wiznet/io_library/ethernet/W5300/w5300.h:
Copyright (c) 2015, WIZnet Co., LTD.
