wiznetmaker-contest/W5300-Camera-ToF-3D/docs/front.jpg

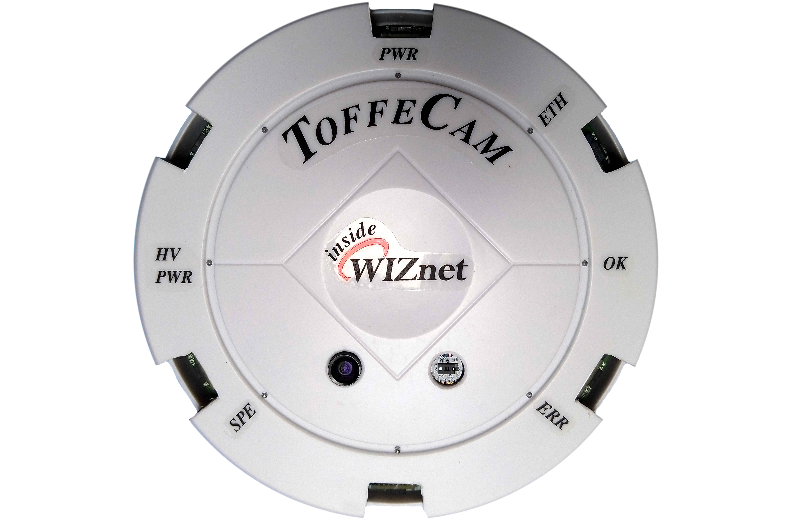
docs/front.jpg
